elin66alpha/AI_figure/assets/renderer/e6ae1a68-8cda-431b-a01b-6ed6c8702f0f.png

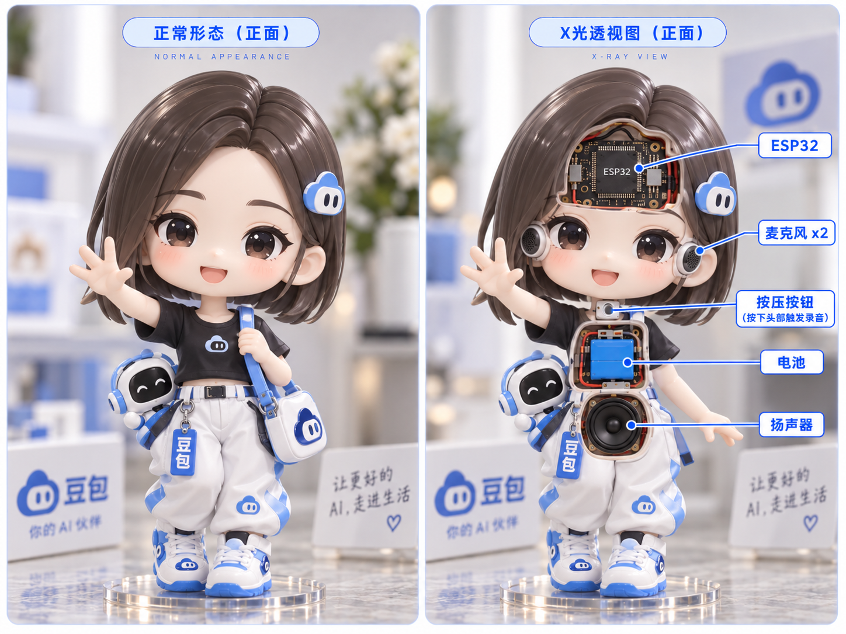
assets/renderer/e6ae1a68-8cda-431b-a01b-6ed6c8702f0f.png
