elin66alpha/AI_figure/assets/renderer/9f44d49e-f947-44cd-aeab-df2c80974dcf.png

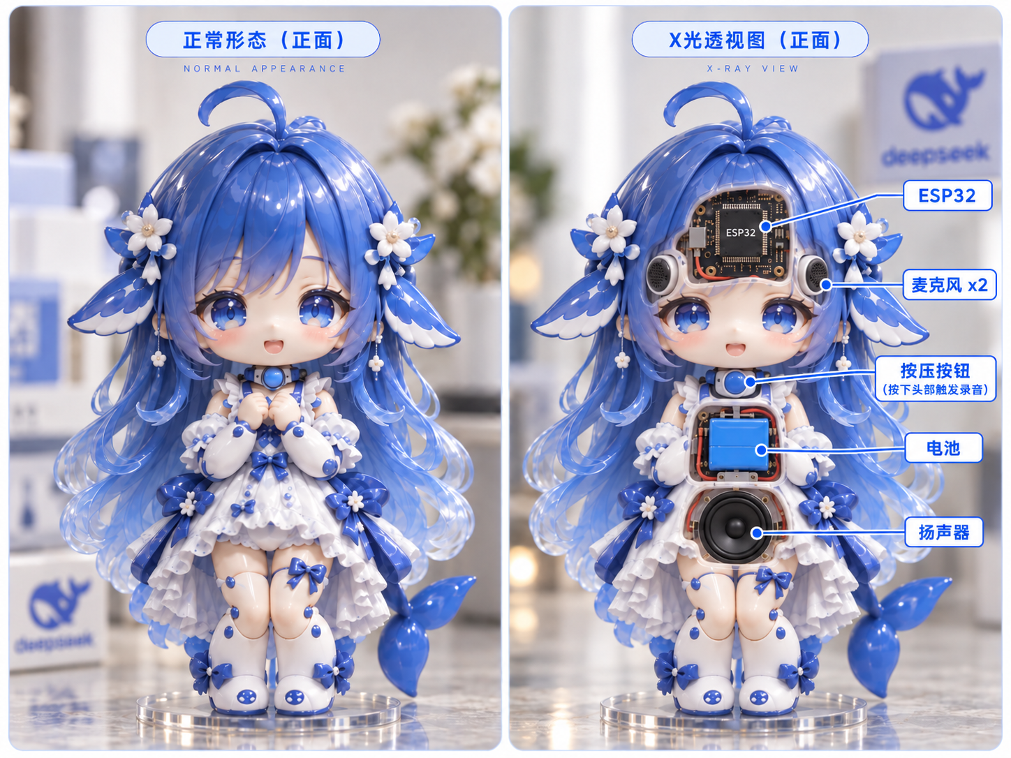
assets/renderer/9f44d49e-f947-44cd-aeab-df2c80974dcf.png
