elin66alpha/AI_figure/hardware/DESIGN_CONSTRAINTS.md

# AI_figure 定制板：最终设计约束

最终工程文件：`ProPrj_AI_figure_2026-10-08.epro2`（嘉立创 EDA 专业版）；BOM：`BOM/BOM_30x50_2026-10-07.csv`；器件手册：`datasheets/`。

## 板子与制造

- 30 × 50 mm 圆角矩形，双层 FR-4，板厚 1.6 mm，1 oz 铜，两面贴片。没有安装孔。
- 过孔 24/12 mil，两面盖油，不做填孔电镀。U2/U5 散热过孔在散热焊盘外侧，用短宽铜线接 EP，不做焊盘内过孔。
- USB D+/D- 两对差分对已等长（长度差约 0）。没有做阻抗控制，也没有向板厂指定阻抗。
- 走线规则：只有 0°/45°/90° 线段，每个拐弯 45°，不要 T 形分支。原生 DRC 通过（0 错误）。
- 位号丝印全部隐藏，板上不印位号；位号本身保留，BOM 和坐标文件靠它对应。

## 机械（外壳设计按此）

- **ESP32 模组 U1**：正面左上角，天线朝上贴顶边。天线下方 x 0–17.2、y 0–5.7 mm 所有铜层禁布。外壳在天线附近尽量不放金属。
- **麦克风 U4（LMD2718T261）**：正面右上 (24.5, 6.0) mm，顶部进声，PCB 不开声孔。四周 Ø10 mm 内不放元件，留给外壳密封垫。
- **电池**：500 mAh 聚合物锂电池，30×30×6 mm，自带保护板，贴在正面下部（y 19.5–50 mm，整板宽）。
- **USB-C J1**：立式（SHOU HAN TYPE-C 16PLT-H6.5，C3151748），在背面中部 (15, 34) mm。
- **J2 / J3 / J4**：电池、喇叭、录音键各一个 2.54 mm 2P 焊盘位，在正面电池上方，直接焊线，不装排针座。
- **喇叭**：Ø20×5 mm，不装在 PCB 上，焊线接 J3。

坐标原点为板子左上角，y 向下，单位 mm。

## 电路取舍

- 电池自带保护板，板上不做保护：已删 DW01A / 8205A，电池负极直接接 GND。
- 充电：ETA6002，R3 = 3.0 kΩ，充电电流约 0.33 A（约 0.67C @ 500 mAh）。NTC 脚接地，不检测电池温度。
- 3.3 V：U3 ETA5060 给主控，U7 TLV75733 单独给功放，两路都从 SYS 降压。电池电压低时 3.3 V 维持不住，固件需要设低电量关机阈值。
- 麦克风为 PDM：CLK = GPIO6，DATA = GPIO0，由软件抽取。功放 NS4168 走 I2S，AMP_CTRL 控制声道选择和关断。
- 电池电压检测：SYS_ADC（GPIO1）测的是 VBAT（电池正极，R14 上端接 VBAT），经 1 MΩ + 1 MΩ 分压、100 nF 滤波。网络名仍叫 SYS_ADC。只用电池时 SYS 比 VBAT 低“负载电流 × 50 mΩ”，低电量关机阈值留约 50 mV 余量；充电时读数偏高约 50–100 mV；不装电池只插 USB 时读数无意义。
- USB 插入检测：VBUS_DET（GPIO20，模组 RXD0 脚 30）= VBUS_CHG 经 R16 68 kΩ / R17 100 kΩ 分压，5 V 时约 3.0 V（4.4–5.5 V 对应 2.6–3.3 V，高于 0.75×VDD）。数字输入，不能从深睡唤醒（C3 深睡唤醒只支持 GPIO0–5）。ETA6002 的 STAT 脚未接。
- 没有 UART 排针，烧录和日志走 USB-Serial-JTAG。EN、BOOT 是测试焊盘 TP1（EN）、TP2（GND）、TP3（BOOT_GPIO9），不进 BOM。
