elin66alpha/AI_figure/ENGINEERING.md

# Engineering Contract

## Deviations

- [open] 2026-10-24: Engineering audit and full contract (Problem, Scope, Architecture, Features, Verification) skipped before adding the offline hardware self-test firmware (firmware/ESP32C3_HwTest) and its remote kit (hardware/bringup/自检包, run via 1-自检.bat). Reason: board bring-up is blocked on a remote engineer who has no network or server; the user asked to build the test firmware first.
