elin66alpha/AI_figure/ROADMAP.md

# ESP32-C3 AI Voice — 后续计划(路线图)

> 这里记录还没做完的计划,写下来是为了在改现有代码时别把路堵死。
> 设备侧规格见 `AGENT.md`,服务器侧见 `SERVER.md`。

---

## 1. 手机端:微信小程序(不做原生 App)

一个微信小程序(`miniprogram/`),按顺序做:① 蓝牙配网 → ② 用户注册/登录(微信登录或其他)→
③ 服务器数据库(用户、密码、订阅等级)+ 订阅付费。免费用户以后可能改用手机本地的 ASR/LLM/TTS,不走付费 API,待定。

| # | 功能 | 链路 | 依赖 |
|---|---|---|---|
| A1 | **蓝牙配网**:给 ESP32-C3 下发 WiFi SSID / 密码 | 小程序 ⇄ BLE ⇄ 设备 | **固件和 `miniprogram/` 已写,待真机验收**(AGENT.md §8) |
| A2 | **配置服务器连接**:服务器域名/端口、设备身份(PSK) | App ⇄ BLE ⇄ 设备 | 同上,且 PSK 要能在服务器侧登记 |
| A3 | **配置付费订阅服务**:选 ASR / TTS / 大模型的厂商与套餐 | App ⇄ HTTPS ⇄ 服务器 | 服务器按设备存配置 + 面向 App 的 API |
| A4 | **调喇叭音量** | App ⇄ 服务器 ⇄ WS ⇄ 设备(或 BLE 直连) | 固件运行期改增益 + 存 NVS |
| A5 | **查看整套系统电量** | 设备 ⇄ WS ⇄ 服务器 ⇄ App | 固件上报电池电压(见 §2) |

---

## 2. 电量 —— 硬件已有,App 侧还没做

定制板已经有电池电压采样(GPIO1,1 MΩ + 1 MΩ 分压)和 USB 插入检测(GPIO20)。
固件目前只用它做低电压保护,并在 `[TLM]` 遥测里打印 VBAT;没有换算成百分比,也没有上报给服务器。
要在小程序里看电量,还差:

- 设备通过 WS 上报电压(新增一条上行控制消息,服务器侧同步支持)
- 服务器转发给小程序
- 按电池放电曲线标定后再换算成百分比;采样放在 IDLE 时做,播放时的大电流压降会让读数偏低
- 插着 USB 充电时读数偏高,不装电池只插 USB 时读数没有意义(`hardware/DESIGN_CONSTRAINTS.md`)

---

## 3. 对现有代码的约束(**实施任何改动时都要记得**)

### 3.1 固件

- **音量要能在运行期改。** `audio_io` 的 `setOutputGain()` / `s_outGain` 是故意保留的运行期变量
  (其余标定旋钮都是编译期常量)。
  App 调音量时:收到新值 -> `setOutputGain()` -> 写 NVS,开机从 NVS 读,读不到用 `OUTPUT_GAIN_DEFAULT`。
  App 端的最大值要在实板上听着定,不能直接放到 256。
- **WiFi 凭据存 NVS**(命名空间 `net`),`secrets.h` 的 WiFi 两行只是开发用兜底。
  服务器地址 / PSK 仍编译期写死在 `secrets.h`,以后要下发时同样走 BLE 配网的加密会话(加自定义端点)。
- **分区是自定义双 OTA**(每槽 0x1E0000),保留了以后远程升级的能力。
- **堆:BLE 和 WiFi+TLS 最好不要同时常驻。** 建议"配网模式"单独进(比如长按按键 / NVS 里没有凭据),
  配完重启进正常模式,正常模式不初始化 BLE。
  **已按此实现**:`network_provisioning` Security 1,小程序端自己实现了协议客户端(`miniprogram/utils/prov.js`)。
- **PSK 就是设备身份**(AGENT.md §7)。配网时下发或生成 PSK 必须走加密通道
  (Security 1 会话里的自定义端点,`network_prov_mgr_endpoint_create`),不能明文走 BLE。
  注意当前**没有 PoP**:下发 PSK 之前要重新评估是否加 PoP。
- **新控制消息不会打坏老固件**:设备本来就静默忽略未知的 `t`(AGENT.md §3.2),
  音量 / 电量消息可以先在服务器上线。

### 3.2 服务器

- **厂商选择要从"全局环境变量"变成"按设备/用户配置"。** `asr.py` / `tts.py` / `llm.py`
  的分派层已经把厂商隔开了,到时候把 `config.*_PROVIDER` 换成按会话读配置即可。
  所以 **火山 `volc_*.py` 等备选厂商代码要保留**,它们会成为 App 里可选的选项。
- **厂商密钥**:用户自带 key 还是平台统一采购再按订阅收费,要先定。前者要加密存储;
  后者要做用量计量(ali_tts 里已经在累计计费字符数 `chars`)。
- **小程序支付**:接微信支付要求小程序主体是**企业或个体工商户**(个人主体不行),
  目前还没有 AppID,注册时就要选对主体。iOS 上小程序卖虚拟服务有平台限制,做到这一步时再查最新规则。
- **设备登记**:现在 PSK 手工写在 `/etc/stunnel/psk.secrets`。设备多了要自动化登记
  (stunnel 支持 `SIGHUP` 重载),或者升级到 Python 3.13 用 `set_psk_server_callback` 查库。
- **小程序需要一个面向手机的 API**(HTTPS + 用户鉴权,微信登录走 `wx.login` -> 服务器换 openid),
  和设备那条 WS 分开。小程序的 request 合法域名必须是备案过的 HTTPS 域名。
  音量下发、电量上报经服务器中转:小程序 -> API -> 找到设备的 WS 会话 -> 下发控制消息。
