elin66alpha/AI_figure/.easyeda/artifacts/20260929-184102-schematic_export-27a93d84.png

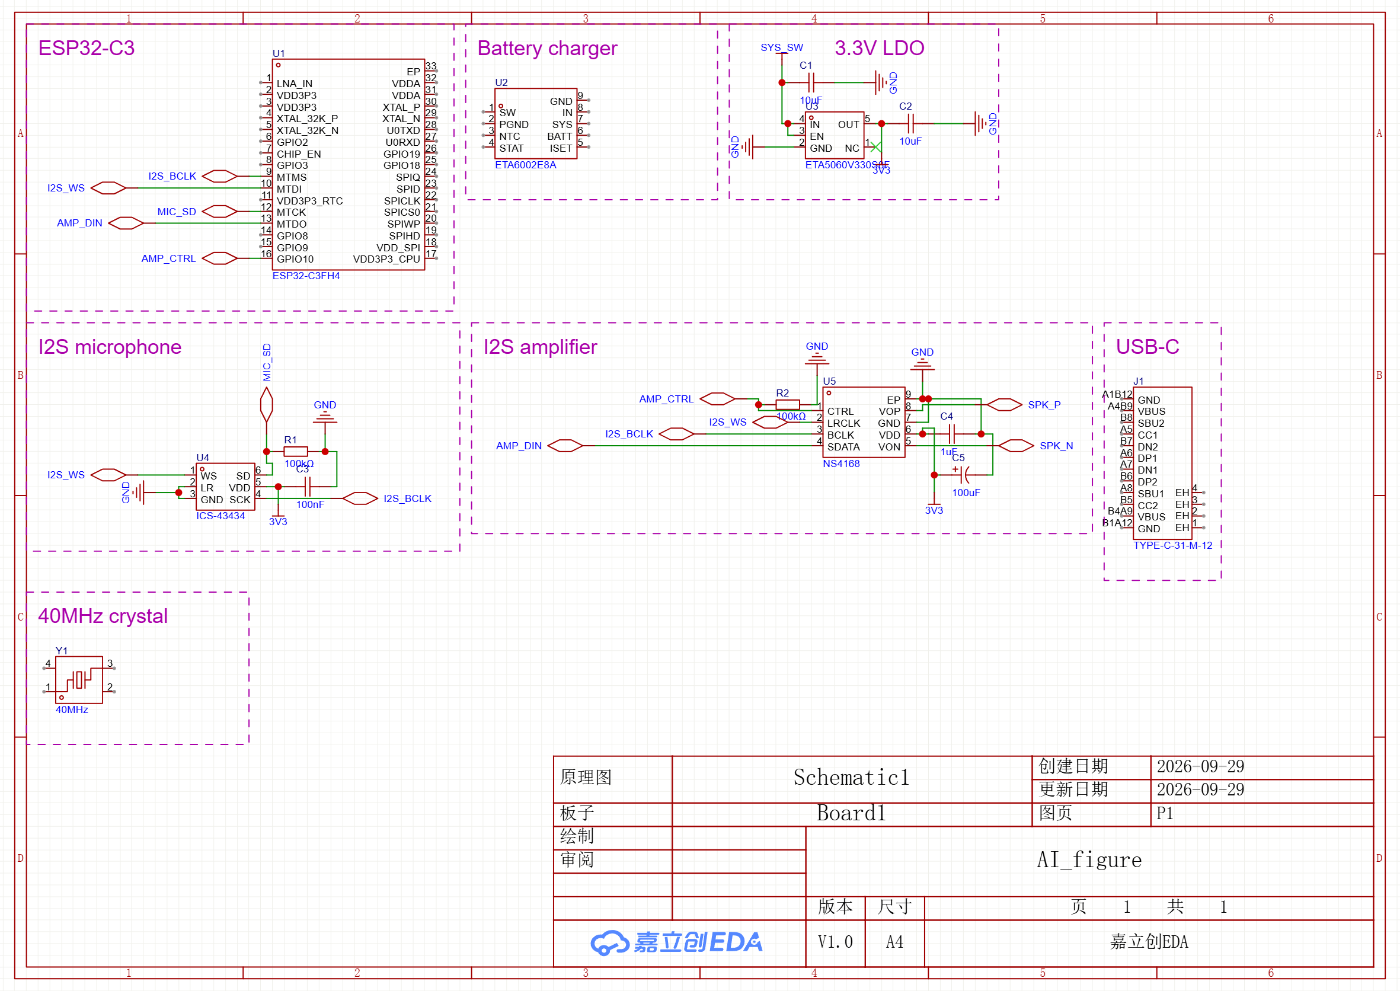
.easyeda/artifacts/20260929-184102-schematic_export-27a93d84.png
