elin66alpha/AI_figure/.easyeda/artifacts/20260929-192454-schematic_export-d0c1aed8.png

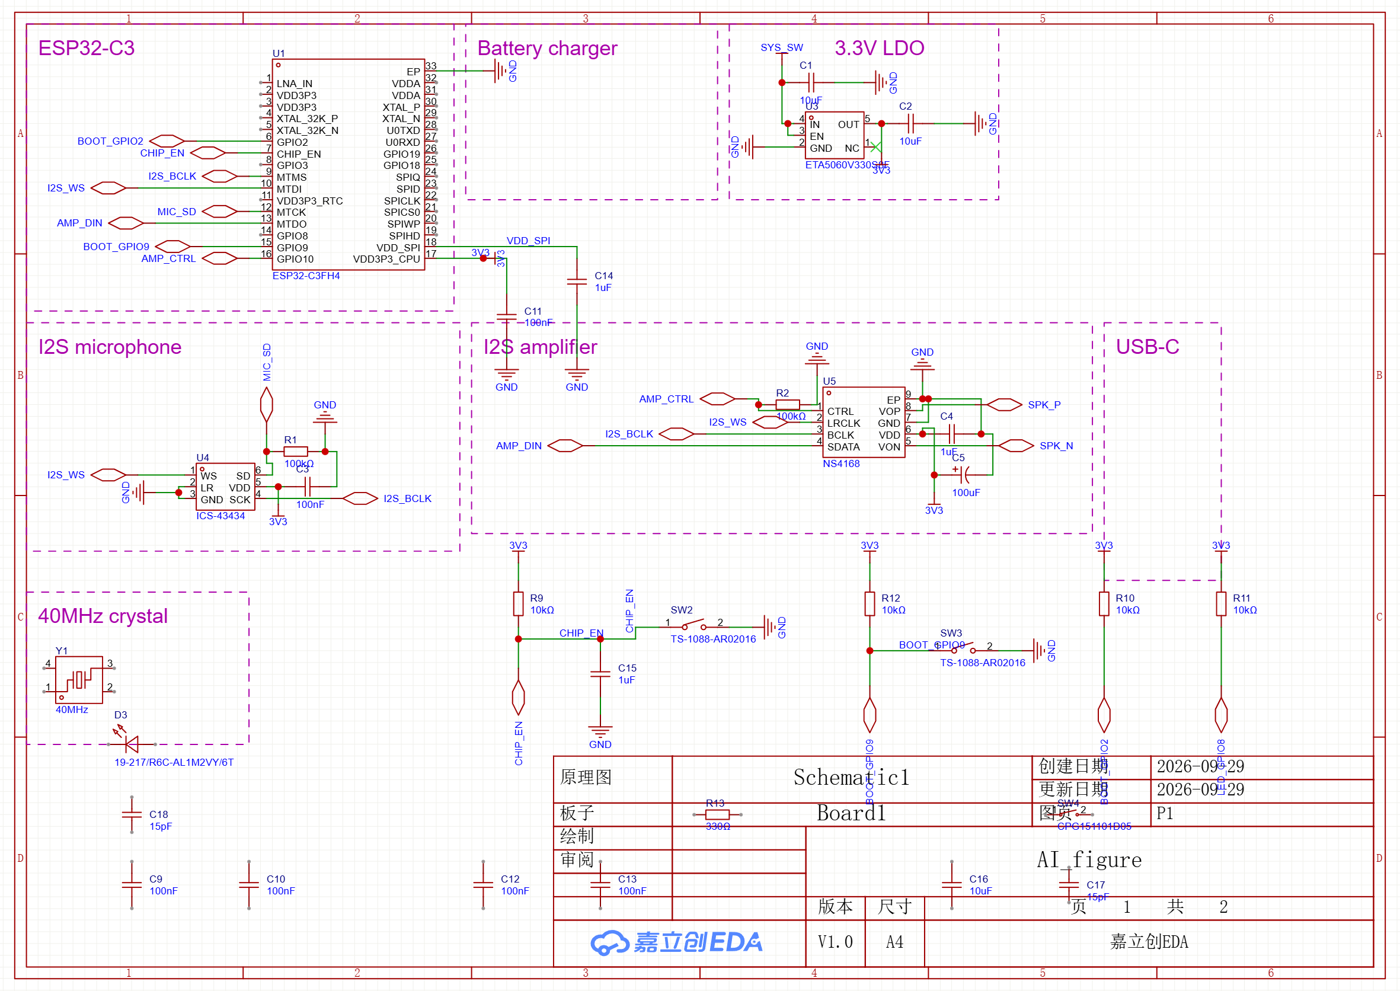
.easyeda/artifacts/20260929-192454-schematic_export-d0c1aed8.png
