elin66alpha/AI_figure/.easyeda/artifacts/20260929-194359-schematic_export-5978b97b.png

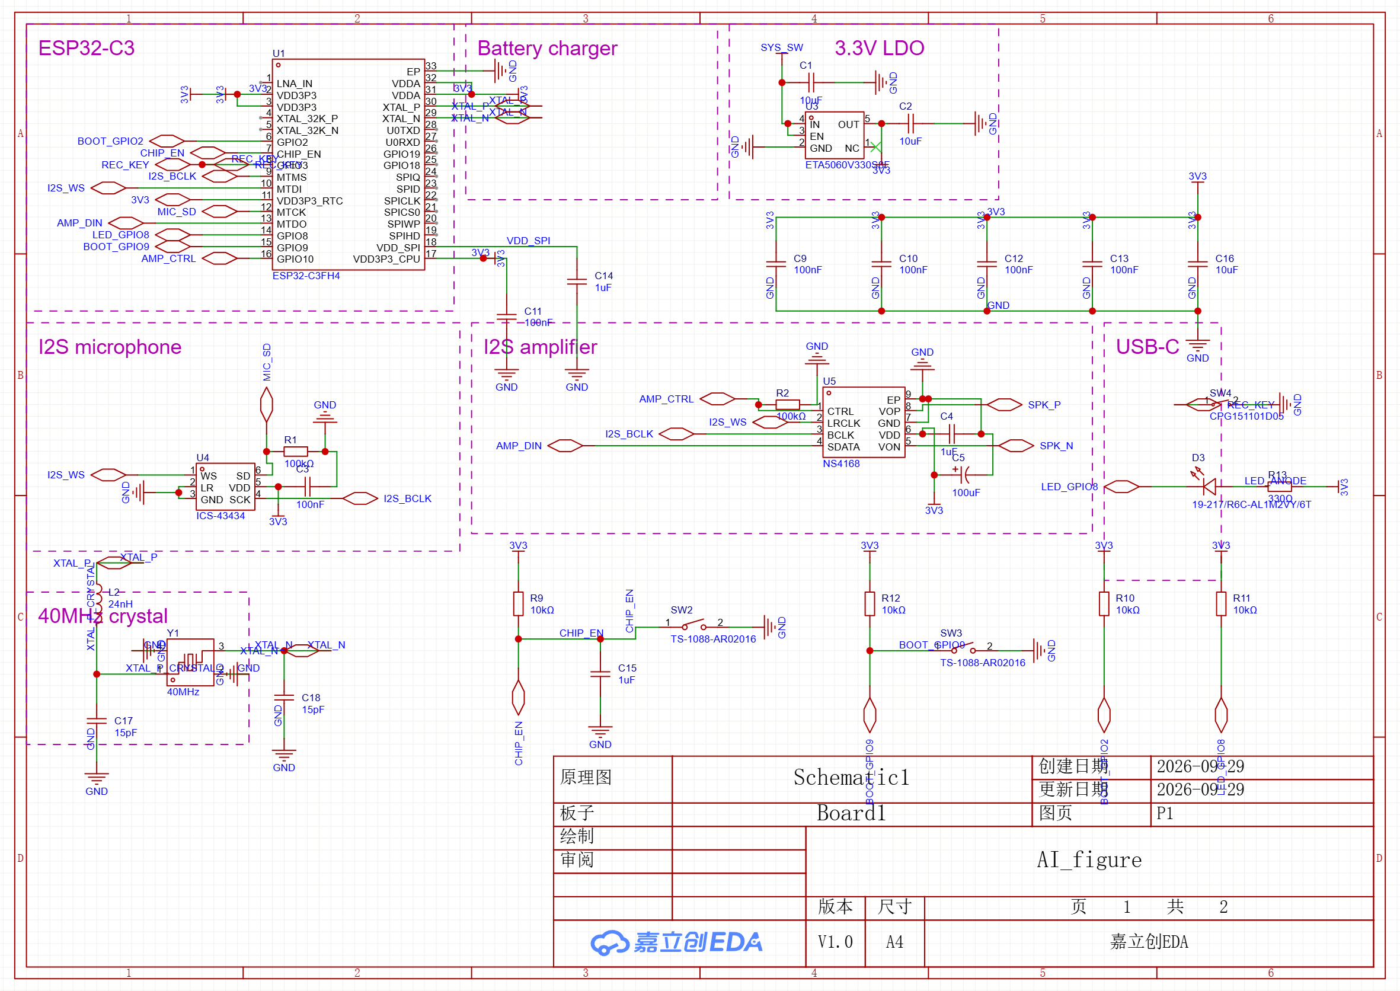
.easyeda/artifacts/20260929-194359-schematic_export-5978b97b.png
