elin66alpha/AI_figure/.easyeda/artifacts/20260929-200443-schematic_export-7b6031b6.png

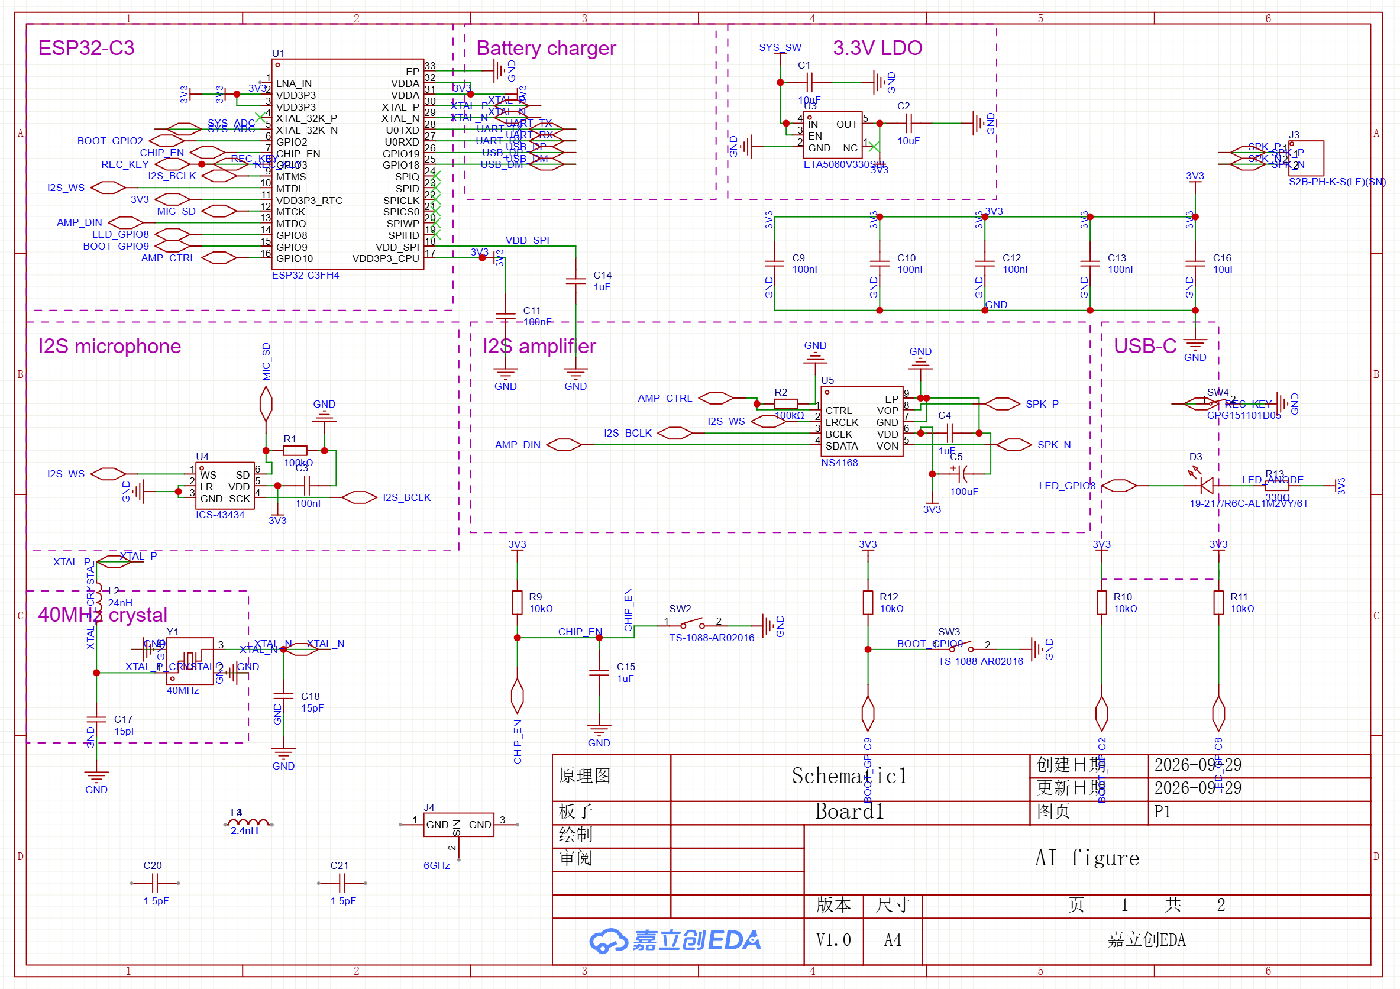
.easyeda/artifacts/20260929-200443-schematic_export-7b6031b6.png
