elin66alpha/AI_figure/.easyeda/artifacts/20260929-200511-schematic_export-a2d3e605.png

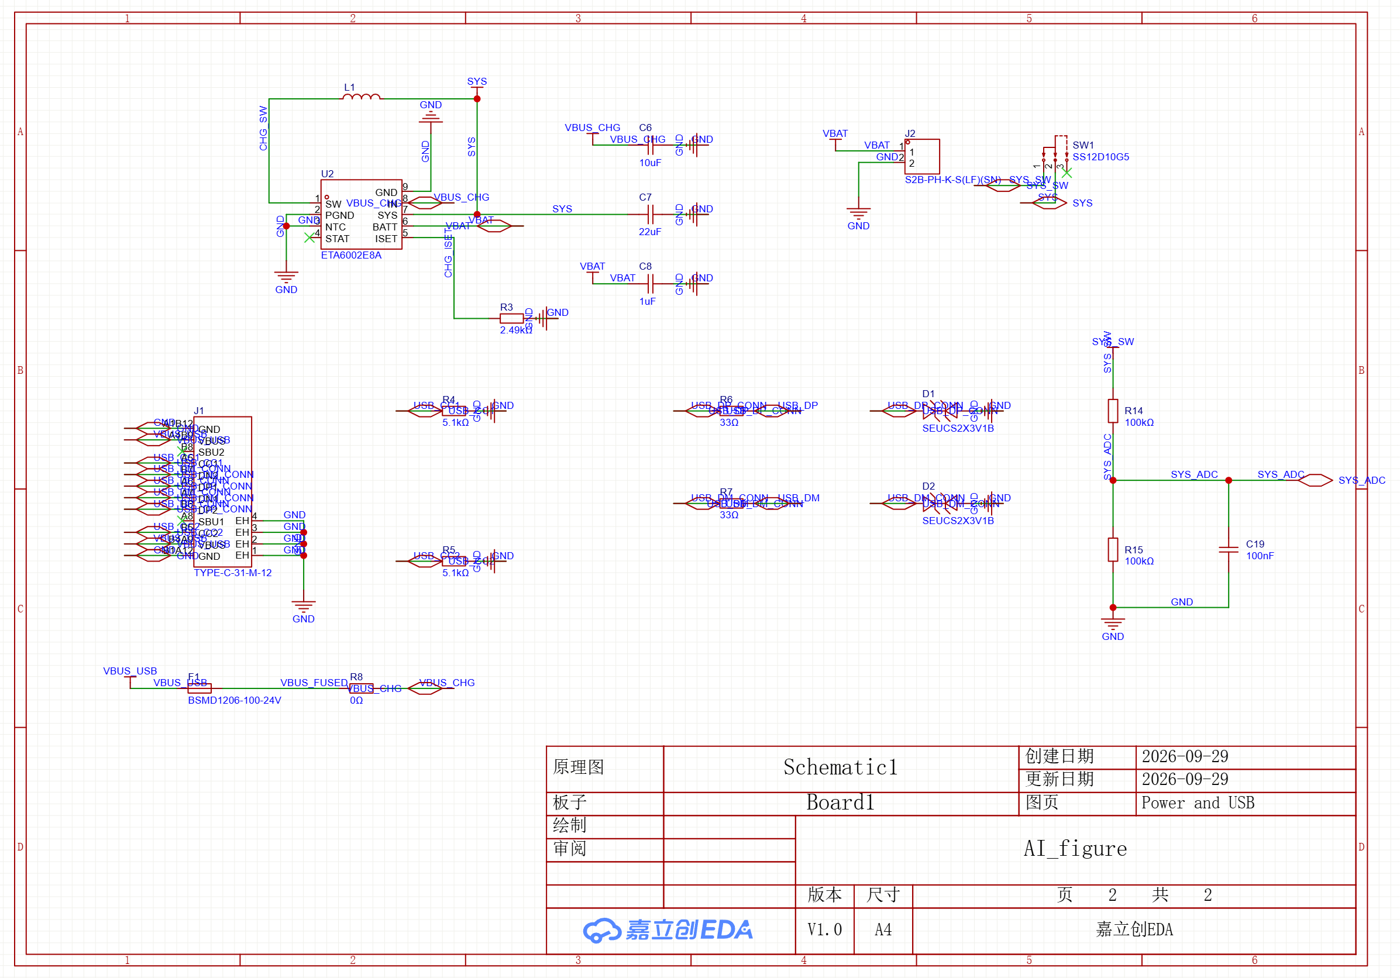
.easyeda/artifacts/20260929-200511-schematic_export-a2d3e605.png
