elin66alpha/AI_figure/.easyeda/artifacts/20260929-202914-schematic_export-4d398066.png

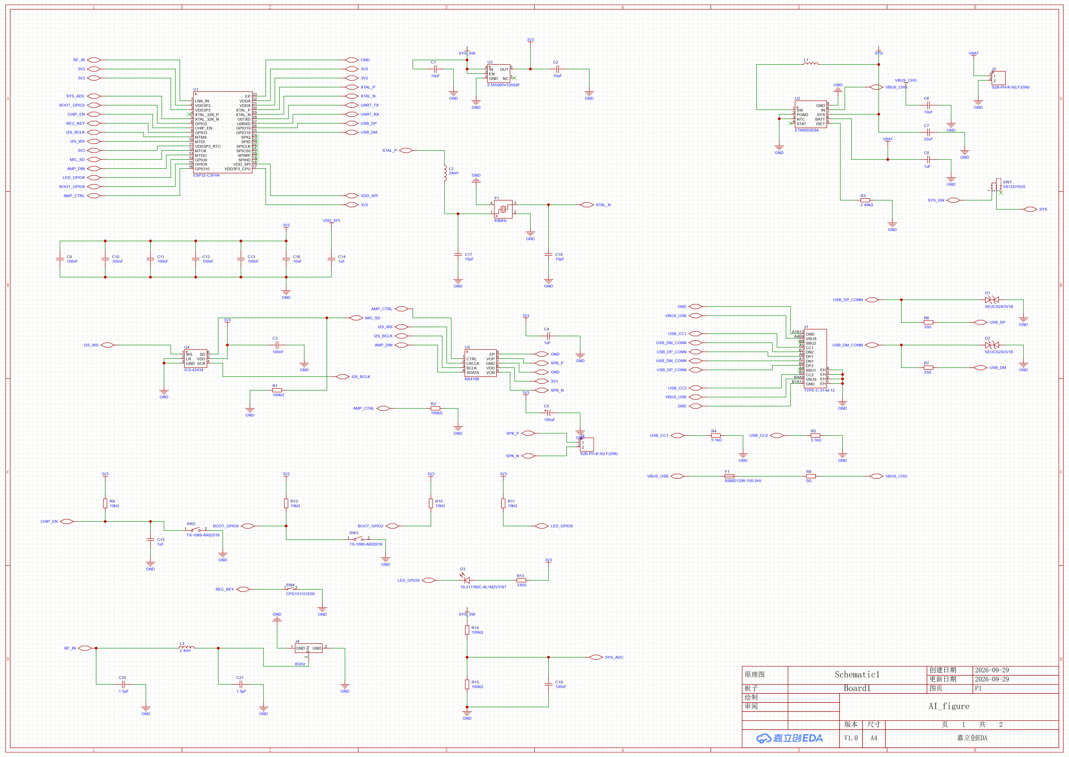
.easyeda/artifacts/20260929-202914-schematic_export-4d398066.png
