elin66alpha/AI_figure/.easyeda/artifacts/20260929-204429-schematic_export-d9c69031.png

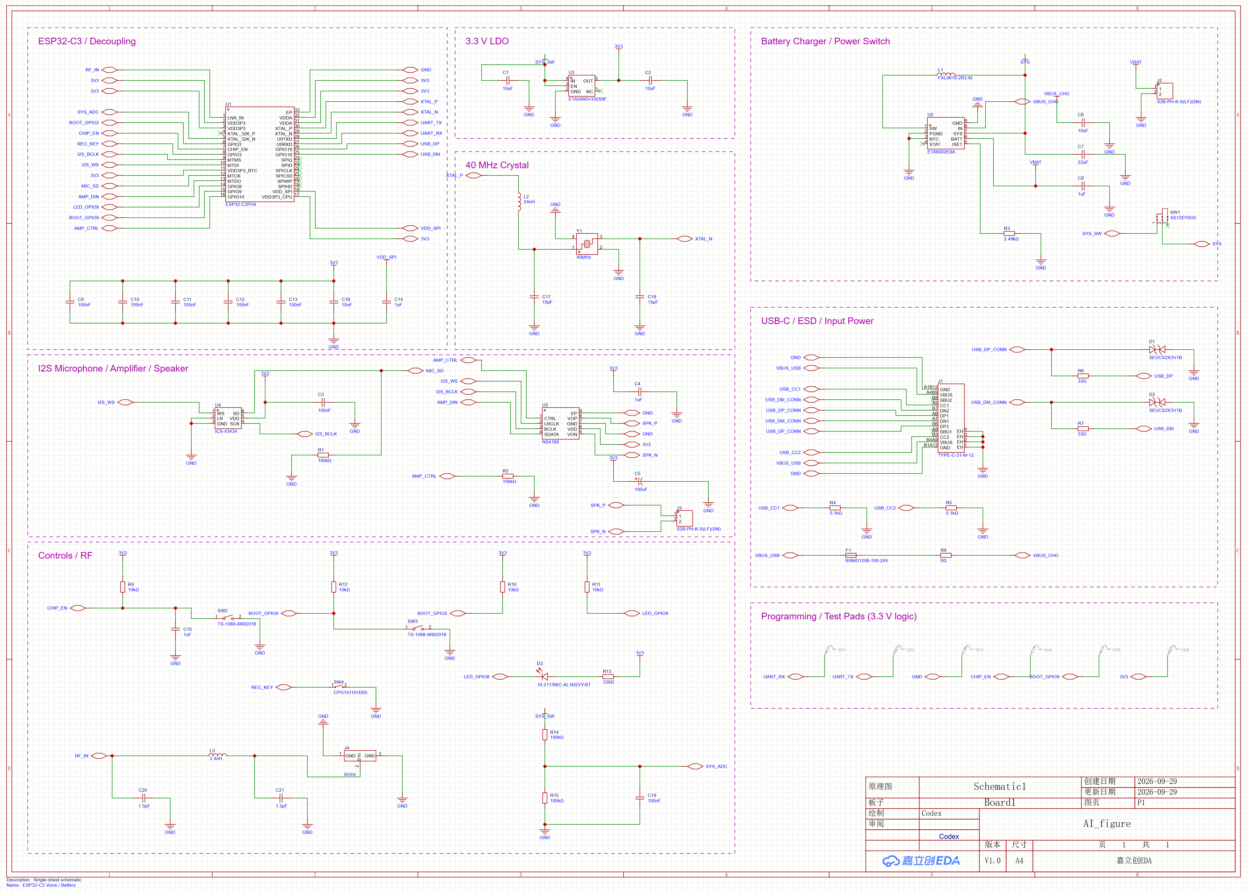
.easyeda/artifacts/20260929-204429-schematic_export-d9c69031.png
