elin66alpha/AI_figure/.easyeda/artifacts/20260929-204615-schematic_export-d0ac80e4.png

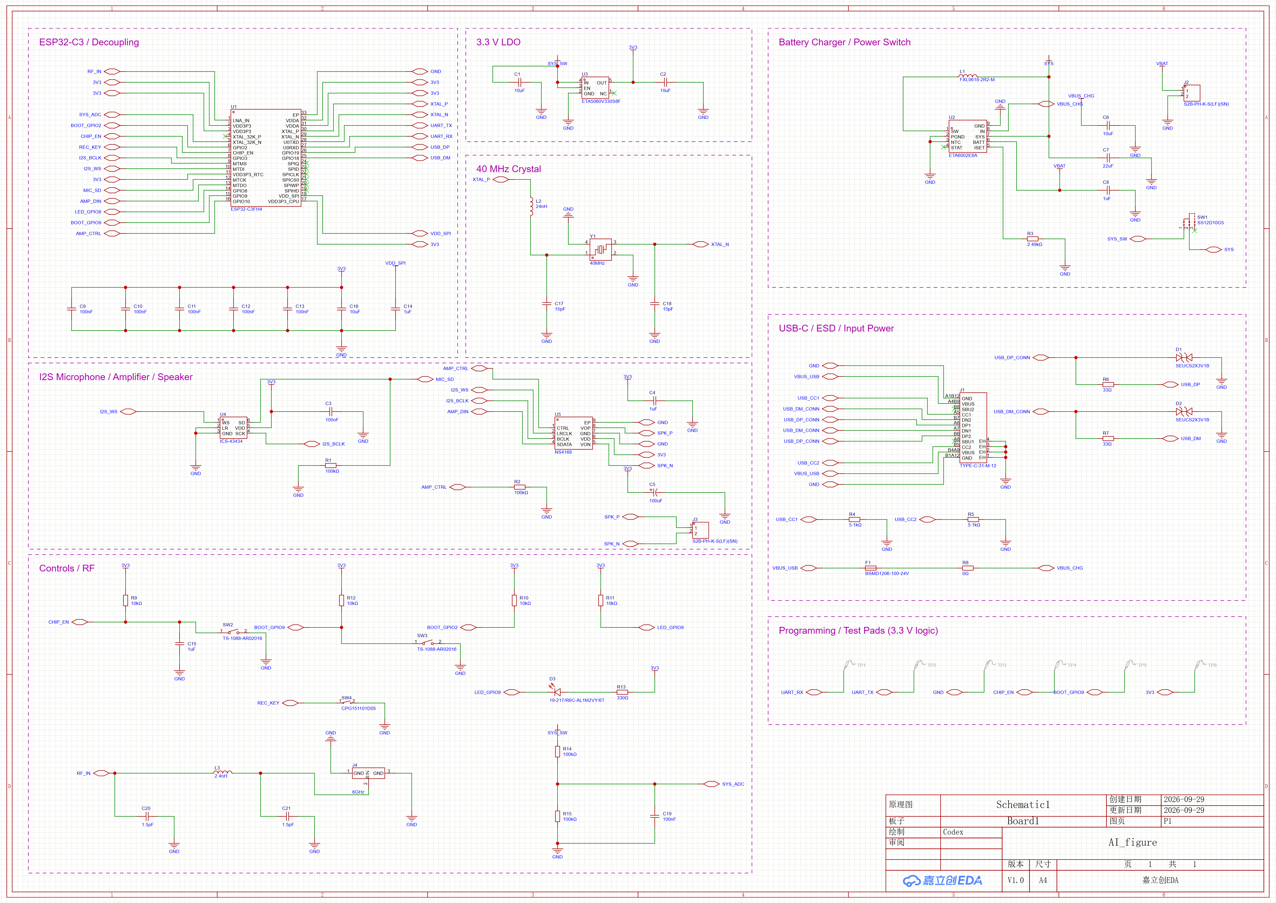
.easyeda/artifacts/20260929-204615-schematic_export-d0ac80e4.png
