elin66alpha/AI_figure/.easyeda/artifacts/20261006-173509-schematic_export-06e082d4.png

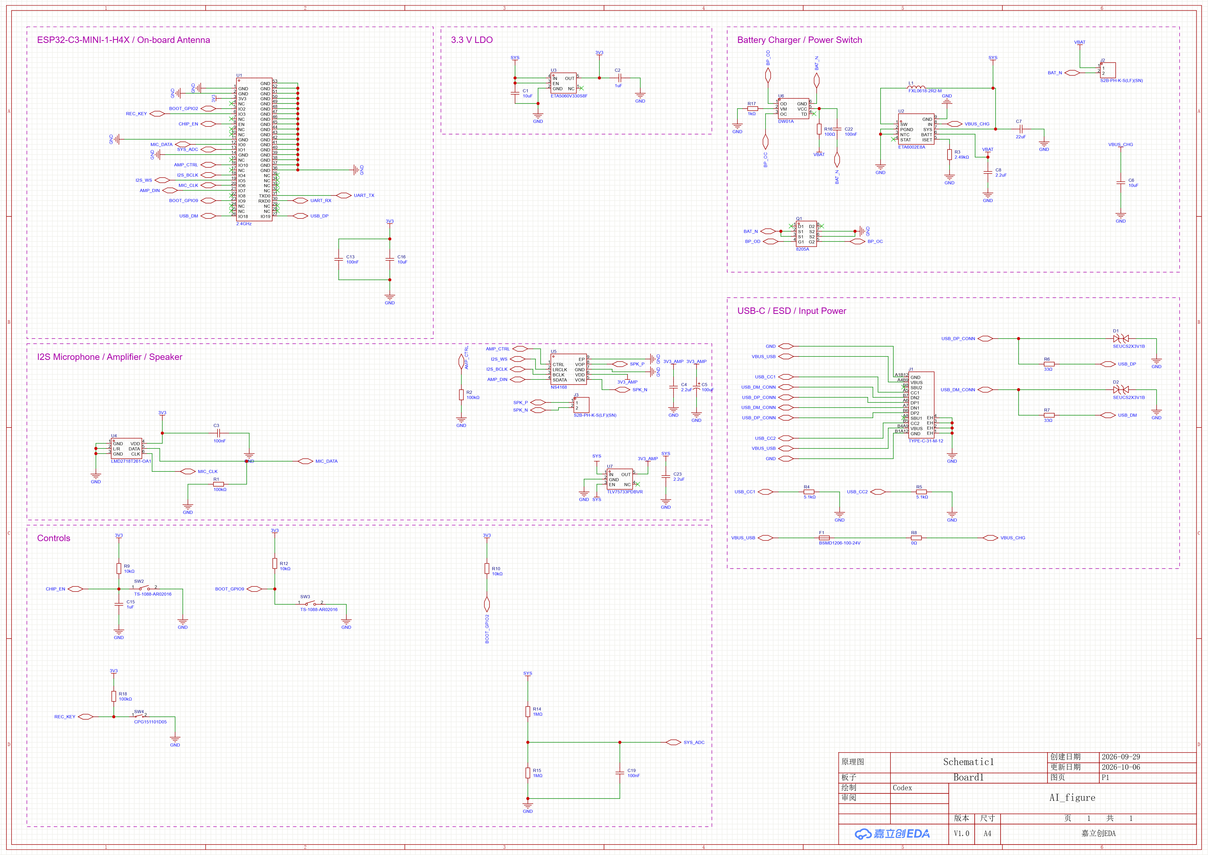
.easyeda/artifacts/20261006-173509-schematic_export-06e082d4.png
