elin66alpha/AI_figure/.easyeda/artifacts/20261006-193431-schematic_export-45f057d5.png

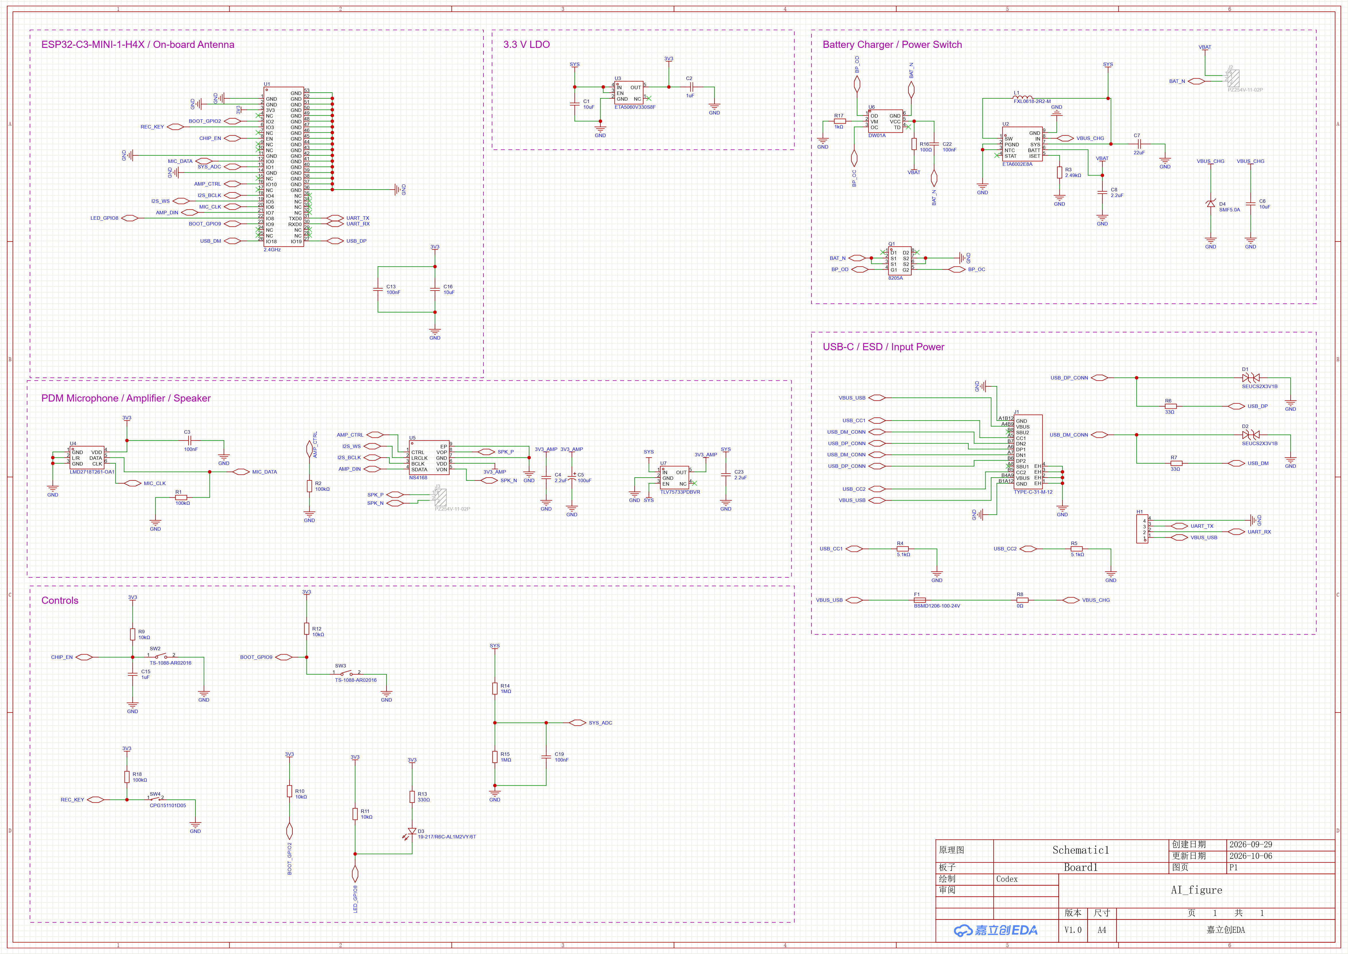
.easyeda/artifacts/20261006-193431-schematic_export-45f057d5.png
