elin66alpha/AI_figure/.easyeda/artifacts/20261006-224235-pcb_snapshot-fa77d5bd.png

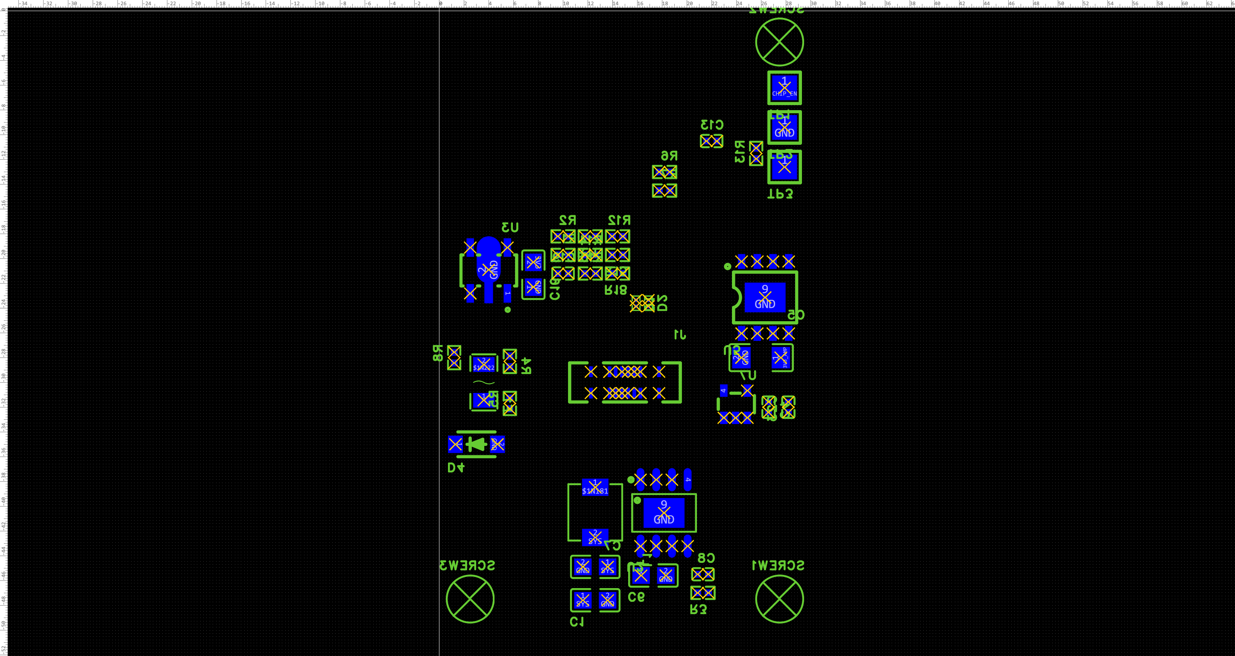
.easyeda/artifacts/20261006-224235-pcb_snapshot-fa77d5bd.png
