elin66alpha/AI_figure/.easyeda/artifacts/20261007-025754-pcb_snapshot-379939ef.png

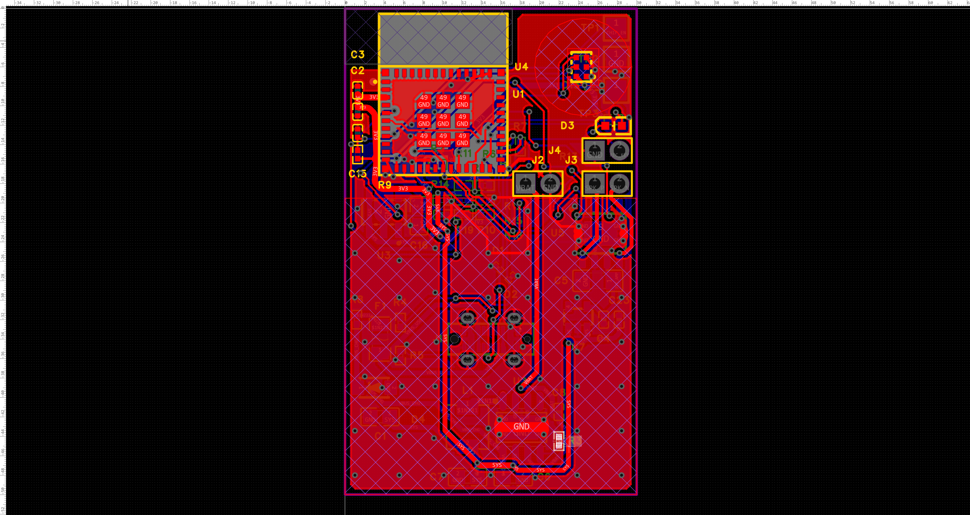
.easyeda/artifacts/20261007-025754-pcb_snapshot-379939ef.png
