elin66alpha/AI_figure/.easyeda/artifacts/20261016-233853-pcb_snapshot-adba5ace.png

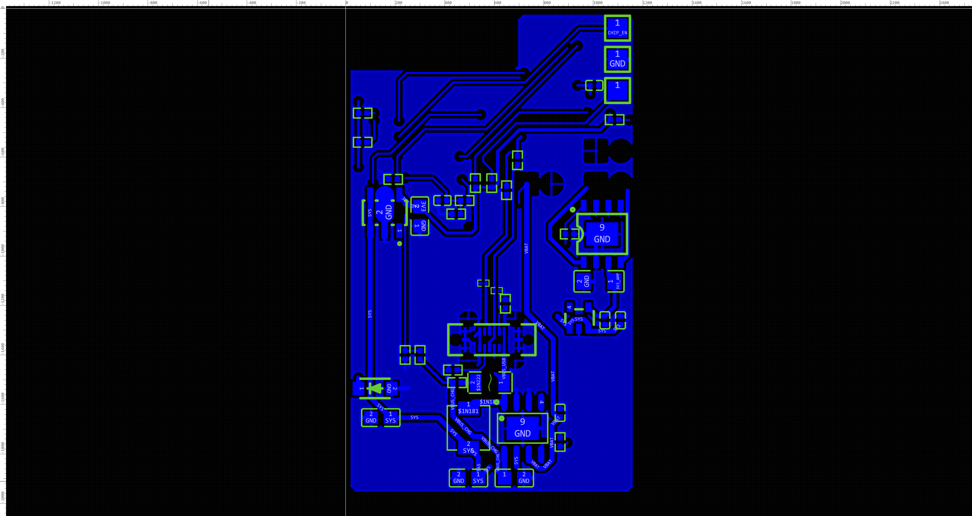
.easyeda/artifacts/20261016-233853-pcb_snapshot-adba5ace.png
