elin66alpha/AI_figure/assets/renderer/649875e9-ef43-426a-9d49-24b67acfeca1.png

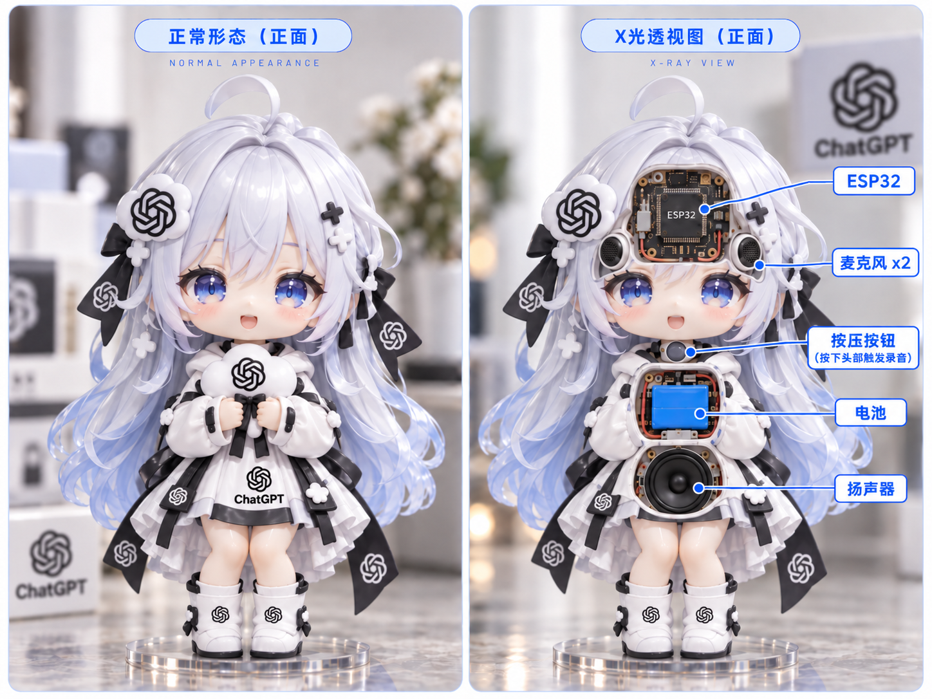
assets/renderer/649875e9-ef43-426a-9d49-24b67acfeca1.png
