elin66alpha/AI_figure/mechanic/export/1a2a62c7fec95a44b6e669c84b1b3a7a.jpg

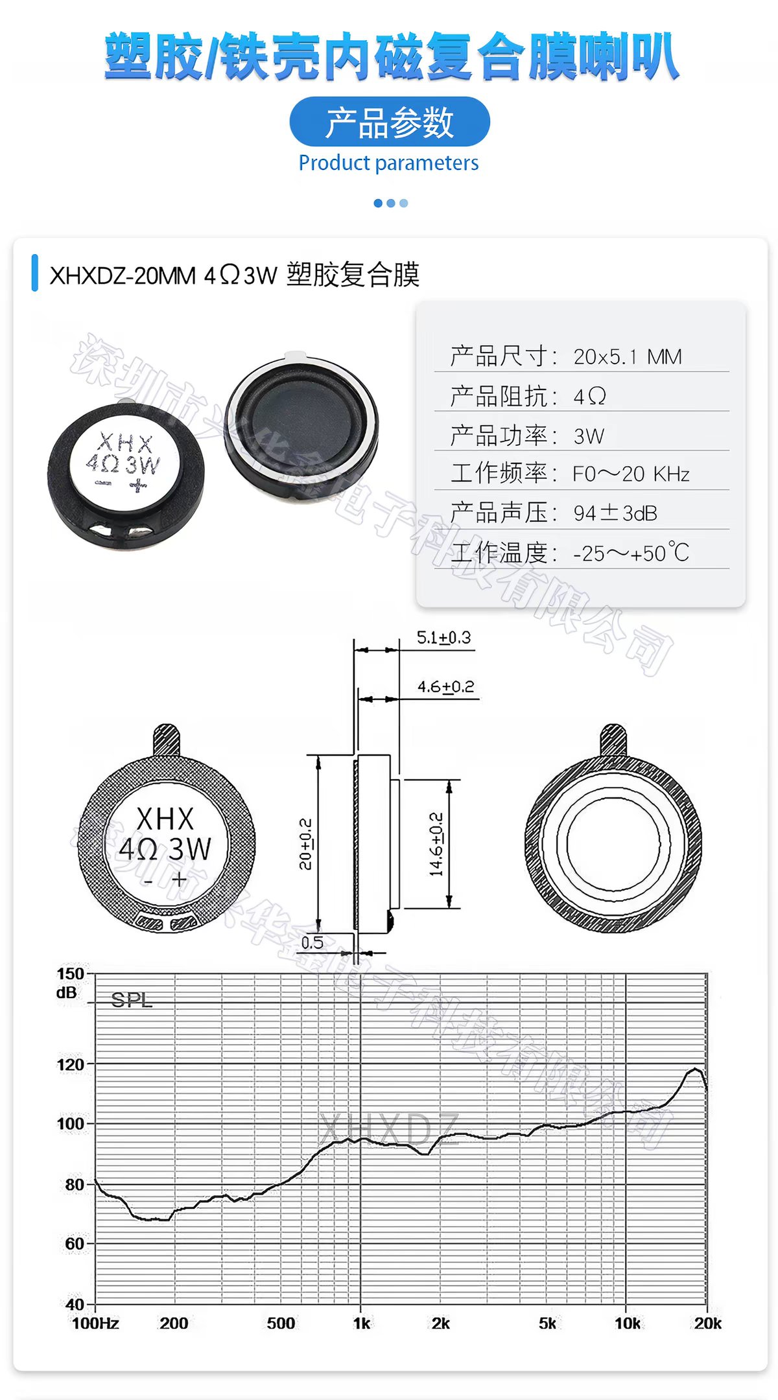
mechanic/export/1a2a62c7fec95a44b6e669c84b1b3a7a.jpg
