elin66alpha/AI_figure/renderer/b0d1a567-6355-4e40-a5f2-5a8ac267f8f7.png

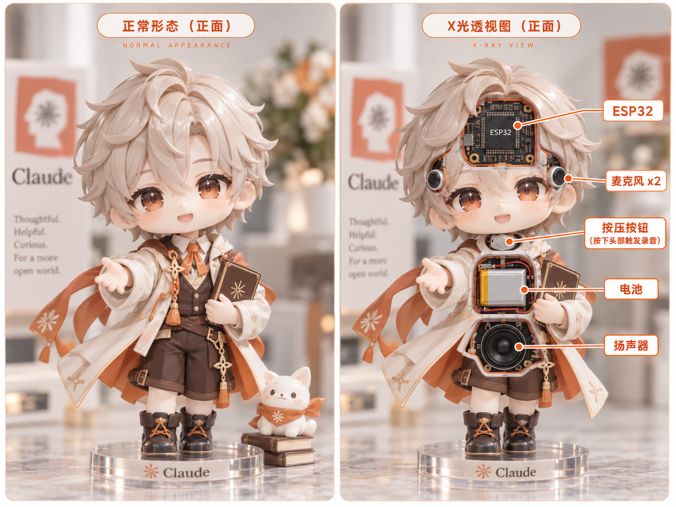
renderer/b0d1a567-6355-4e40-a5f2-5a8ac267f8f7.png
