elin66alpha/AI_figure/hardware/assembly/purchase.csv

row | first_designator | qty_per_board | mpn | brand | package | lcsc | qty_bought
1 | C1 | 3 | HGC0805R5106K250NSLJ | Chinocera(华瓷) | 0805 | C19103847 | 30
2 | C2 | 2 | GRM155R61E105KA12D | muRata(村田) | 0402 | C77009 | 100
3 | C3 | 3 | CL05B104KO5NNNC | SAMSUNG(三星) | 0402 | C1525 | 100
4 | C4 | 3 | CL05A225KA5NUNC | SAMSUNG(三星) | 0402 | C307418 | 40
5 | C5 | 1 | CL31A107MQHNNNE | SAMSUNG(三星) | 1206 | C15008 | 10
6 | C7 | 1 | 0805X226M100NT | FH(风华) | 0805 | C503482 | 10
7 | D1 | 2 | SEUCS2X3V1B | ElecSuper(静芯) | DFN0603-2 | C42400191 | 20
8 | D3 | 1 | 19-217/R6C-AL1M2VY/6T | EVERLIGHT(亿光) | 0603 | C2986060 | 50
9 | D4 | 1 | SMF5.0A | JSMSEMI(杰盛微) | SOD-123FL | C2857263 | 50
10 | F1 | 1 | BSMD1206-100-24V | BHFUSE(佰宏) | 1206 | C910830 | 10
11 | J1 | 1 | TYPE-C 16PLT-H6.5 | SHOU HAN(首韩) | SMD | C3151748 | 10
12 | L1 | 1 | FXL0420-2R2-M | cjiang(长江微电) | SMD 4.4x4.2 | C167206 | 10
13 | R1 | 4 | 0402WGF1003TCE | UNI-ROYAL(厚声) | 0402 | C25741 | 100
14 | R3 | 1 | FRC0402F3001TS | FOJAN(富捷) | 0402 | C2909355 | 100
15 | R4 | 2 | 0402WGF5101TCE | UNI-ROYAL(厚声) | 0402 | C25905 | 100
16 | R6 | 2 | RC0402FR-0733RL | YAGEO(国巨) | 0402 | C138002 | 100
17 | R8 | 1 | FRC0402F0000TS | FOJAN(富捷) | 0402 | C2906858 | 100
18 | R9 | 4 | FRC0402F1002TS | FOJAN(富捷) | 0402 | C2906861 | 100
19 | R13 | 1 | 0402WGF3300TCE | UNI-ROYAL(厚声) | 0402 | C25104 | 100
20 | R14 | 2 | 0402WGF1004TCE | UNI-ROYAL(厚声) | 0402 | C26083 | 100
21 | R16 | 1 | 0402WGF6802TCE | UNI-ROYAL(厚声) | 0402 | C36871 | 100
22 | U1 | 1 | ESP32-C3-MINI-1-H4X | ESPRESSIF(乐鑫) | SMD 16.6x13.2 | C41349510 | 10
23 | U2 | 1 | ETA6002E8A | ETA(钰泰) | ESOP-8 | C7436031 | 10
24 | U3 | 1 | ETA5060V330S8F | ETA(钰泰) | SOT89-5 | C7465551 | 10
25 | U4 | 1 | LMD2718T261-OA1 | LinkMems(聆麦声学) | SMD-6P 2.8x1.9 | C5373237 | 10
26 | U5 | 1 | NS4168 | Nsiway(纳芯威) | ESOP-8-EP | C910588 | 10
27 | U7 | 1 | TLV75733PDBVR | TI(德州仪器) | SOT-23-5 | C485517 | 10
