elin66alpha/AI_figure/.easyeda/artifacts/20261005-003304-schematic_bom-d3196b7b.csv

No. | Quantity | Comment | Designator | Footprint | Value | Manufacturer Part | Manufacturer | Supplier Part | Supplier
1 | 3 | 10uF | C1,C6,C16 | C0805 | 10uF | HGC0805R5106K250NSLJ | Chinocera(华瓷) | C19103847 | LCSC
2 | 2 | 1uF | C2,C15 | C0402 | 1uF | CL05A105KA5NQNC | SAMSUNG(三星) | C52923 | LCSC
3 | 4 | 100nF | C3,C13,C19,C22 | C0402 | 100nF | CL05B104KO5NNNC | SAMSUNG(三星) | C1525 | LCSC
4 | 3 | 2.2uF | C4,C8,C23 | C0402 | 2.2uF | CL05A225KA5NUNC | SAMSUNG(三星) | C307418 | LCSC
5 | 1 | 100uF | C5 | CAP-SMD_BD5.0-L5.3-W5.3-LS6.0-FD-H5.4 | 100uF | RVT6.3V100M5X5 | JIERR(捷而瑞) | C49233126 | LCSC
6 | 1 | 22uF | C7 | C0805 | 22uF | 0805X226M100NT | FH(风华) | C503482 | LCSC
7 | 2 | SEUCS2X3V1B | D1,D2 | DFN0603-2L-BI |  | SEUCS2X3V1B | ElecSuper(静芯) | C42400191 | LCSC
8 | 1 | 19-217/R6C-AL1M2VY/6T | D3 | LED0603-R-FD |  | 19-217/R6C-AL1M2VY/6T | EVERLIGHT(亿光) | C2986060 | LCSC
9 | 1 | BSMD1206-100-24V | F1 | F1206 |  | BSMD1206-100-24V | BHFUSE(佰宏) | C910830 | LCSC
10 | 1 | TYPE-C-31-M-12 | J1 | USB-C_SMD-TYPE-C-31-M-12_1 |  | TYPE-C-31-M-12 | 韩国韩荣 | C165948 | LCSC
11 | 2 | S2B-PH-K-S(LF)(SN) | J2,J3 | CONN-TH_S2B-PH-K-S-LF-SN |  | S2B-PH-K-S(LF)(SN) | JST | C173752 | LCSC
12 | 1 | FXL0618-2R2-M | L1 | IND-SMD_L7.0-W6.6_FXL0630 |  | FXL0618-2R2-M | cjiang(长江微电) | C524593 | LCSC
13 | 1 | 8205A | Q1 | TSSOP-8_L4.4-W3.0-P0.65-LS6.4-TL | 8205A | 8205A | TECH PUBLIC(台舟) | C7419210 | LCSC
14 | 3 | 100kΩ | R1,R2,R18 | R0402 | 100kΩ | 0402WGF1003TCE | UNI-ROYAL(厚声) | C25741 | LCSC
15 | 1 | 2.49kΩ | R3 | R0402 | 2.49kΩ | 0402WGF2491TCE | UNI-ROYAL(厚声) | C25884 | LCSC
16 | 2 | 5.1kΩ | R4,R5 | R0402 | 5.1kΩ | 0402WGF5101TCE | UNI-ROYAL(厚声) | C25905 | LCSC
17 | 2 | 33Ω | R6,R7 | R0402 | 33Ω | RC0402FR-0733RL | YAGEO(国巨) | C138002 | LCSC
18 | 1 | 0Ω | R8 | R0402 | 0Ω | 0402WGF0000TCE | UNI-ROYAL(厚声) | C17168 | LCSC
19 | 4 | 10kΩ | R9,R10,R11,R12 | R0402 | 10kΩ | 0402WGF1002TCE | UNI-ROYAL(厚声) | C25744 | LCSC
20 | 1 | 330Ω | R13 | R0402 | 330Ω | 0402WGF3300TCE | UNI-ROYAL(厚声) | C25104 | LCSC
21 | 2 | 1MΩ | R14,R15 | R0402 | 1MΩ | 0402WGF1004TCE | UNI-ROYAL(厚声) | C26083 | LCSC
22 | 1 | 100Ω | R16 | R0402 | 100Ω | RC0402FR-07100RL | YAGEO(国巨) | C106232 | LCSC
23 | 1 | 1kΩ | R17 | R0402 | 1kΩ | RC0402FR-071KL | YAGEO(国巨) | C106235 | LCSC
24 | 2 | TS-1088-AR02016 | SW2,SW3 | SW-SMD_L3.9-W3.0-P4.45 |  | TS-1088-AR02016 | XUNPU(讯普) | C720477 | LCSC
25 | 1 | CPG151101D05 | SW4 | SW-TH_CPG151101D05 |  | CPG151101D05 | HanElectricity(瀚源) | C49234236 | LCSC
26 | 1 | 2.4GHz | U1 | WIFIM-SMD_ESP32-C3-MINI-1 | 2.4GHz | ESP32-C3-MINI-1-H4X | ESPRESSIF(乐鑫) | C41349510 | LCSC
27 | 1 | ETA6002E8A | U2 | ESOP-8_L4.9-W3.9-P1.27-LS6.0-BL-EP-1 |  | ETA6002E8A | ETA(钰泰) | C7436031 | LCSC
28 | 1 | ETA5060V330S8F | U3 | SOT-89-5_L4.5-W2.5-P1.50-LS4.6-BL |  | ETA5060V330S8F | ETA(钰泰) | C7465551 | LCSC
29 | 1 | ICS-43434 | U4 | MIC-SMD_6P-L3.5-W2.7-P0.90-BL |  | ICS-43434 | TDK InvenSense(应美盛) | C5656610 | LCSC
30 | 1 | NS4168 | U5 | ESOP-8_L4.9-W3.9-P1.27-LS6.0-BL-EP |  | NS4168 | Nsiway(纳芯威) | C910588 | LCSC
31 | 1 | DW01A | U6 | SOT-23-6_L2.9-W1.6-P0.95-LS2.8-BL |  | DW01A | PUOLOP(迪浦) | C351410 | LCSC
32 | 1 | TLV75733PDBVR | U7 | SOT-23-5_L2.9-W1.6-P0.95-LS2.8-BL |  | TLV75733PDBVR | TI(德州仪器) | C485517 | LCSC
