elin66alpha/AI_figure/hardware/BOM/c3bfd9e86d0bf8306d8e2dab7f3f90c9.png

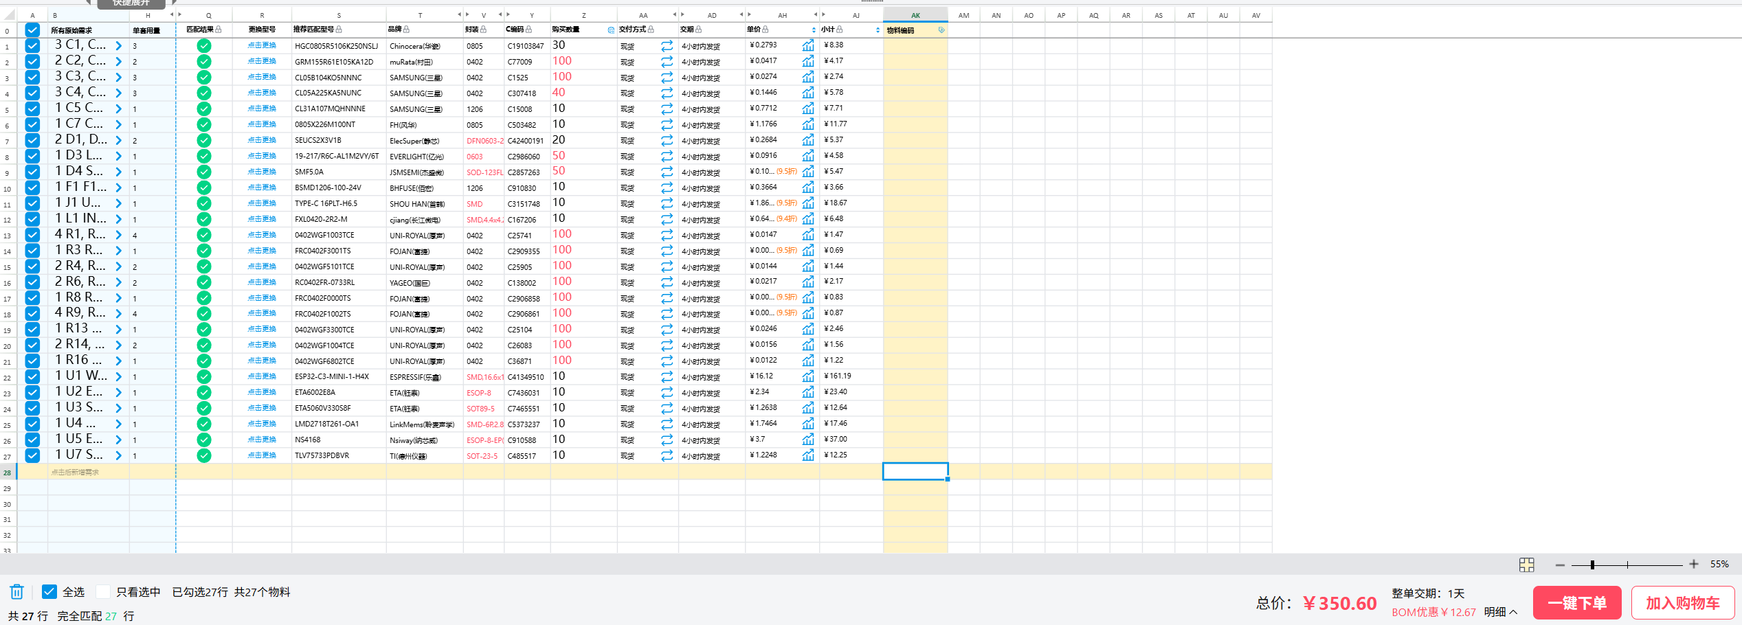
hardware/BOM/c3bfd9e86d0bf8306d8e2dab7f3f90c9.png
