elin66alpha/AI_figure/mechanic/3D_PCB1_2026-10-17.step

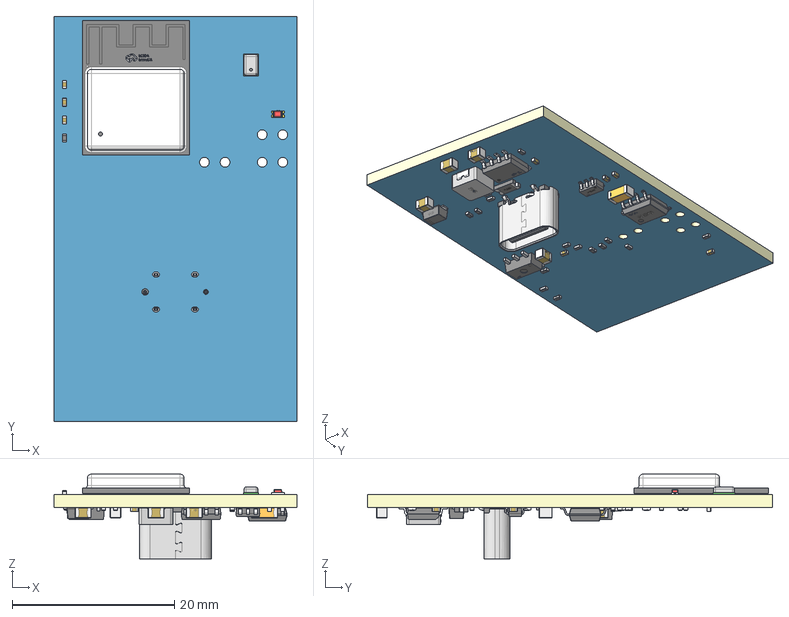
[picture p20: CAD file, 2026-10-17]
mechanic/3D_PCB1_2026-10-17.step
30.0 x 50.0 x 10.5 mm
Board~6WFS
TopCopper~6WFS
BottomCopper~6WFS
TopSilkscreen~6WFS
BottomSilkscreen~6WFS
TopFpcStiffener~6WFS
BottomFpcStiffener~6WFS
C0805~C0805_L2.0-W1.3-H1.3~3wkt x 4
LED0603-R-FD~LED0603-R-FD~t7OX
C0402~C0402_L1.0-W0.5-H0.5~WAJ9 x 8
SOD-123FL_L2.8-W1.9-LS3.7-RD~SOD-123FL_L2.8-W1.9-LS3.7-RD~KsN1
ESOP-8_L4.9-W3.9-P1.27-LS6.0-BL-EP-1~ESOP-8_L4.9-W3.9-P1.27-LS6.0-BL-EP-1~gckc
R0402~R0402_L1.0-W0.5-H0.4~1101 x 18
WIFIM-SMD_ESP32-C3-MINI-1~WIFIM-SMD_ESP32-C3-MINI-1~13lQ
SOT-89-5_L4.5-W2.5-P1.50-LS4.6-BL~SOT-89-5_L4.5-W2.5-P1.50-LS4.6-BL~4WXr
DFN0603-2L-BI~DFN0603-2L-BI-L0.6-W0.3-H0.3~PuRC x 2
C1206~C1206_L3.2-W1.6-H1.3~e1X0
USB-C-SMD_SOUHAN_TYPE-C-16PLT-H6.5~USB-C-SMD_SOUHAN_TYPE-C-16PLT-H6.5~AH2a
MIC-SMD_6P-L2.8-W1.9-P0.98-TL~MIC-SMD_6P-L2.8-W1.9-P0.98-TL~gMpa
IND-SMD_L4.4-W4.2~IND-SMD_L4.2-W4.4-H2.0~5kyt
SOT-23-5_L2.9-W1.6-P0.95-LS2.8-BL~SOT-23-5_L2.9-W1.6-P0.95-LS2.8-BL~qgnL
F1206~F1206_L3.2-W1.7-H0.6~XRz8
ESOP-8_L4.9-W3.9-P1.27-LS6.0-BL-EP~ESOP-8_L4.9-W3.9-H1.6-LS6.0-P1.27~GiWC
