elin66alpha/AI_figure/mechanic/export/背板.step

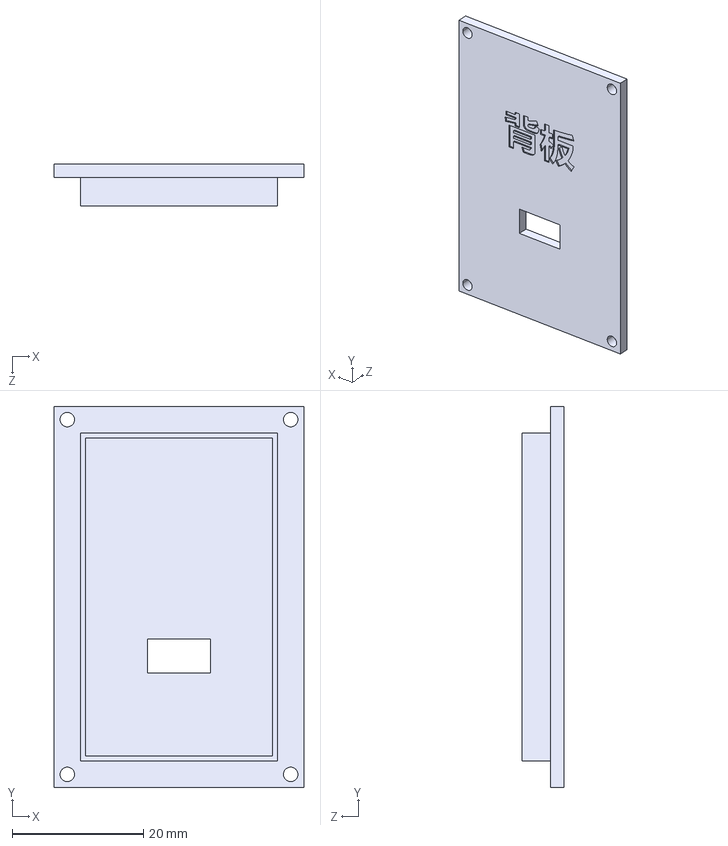
[picture p21: CAD file, 2026-10-10]
mechanic/export/背板.step
38.0 x 58.0 x 6.35 mm
