elin66alpha/AI_figure/mechanic/export/头部.step

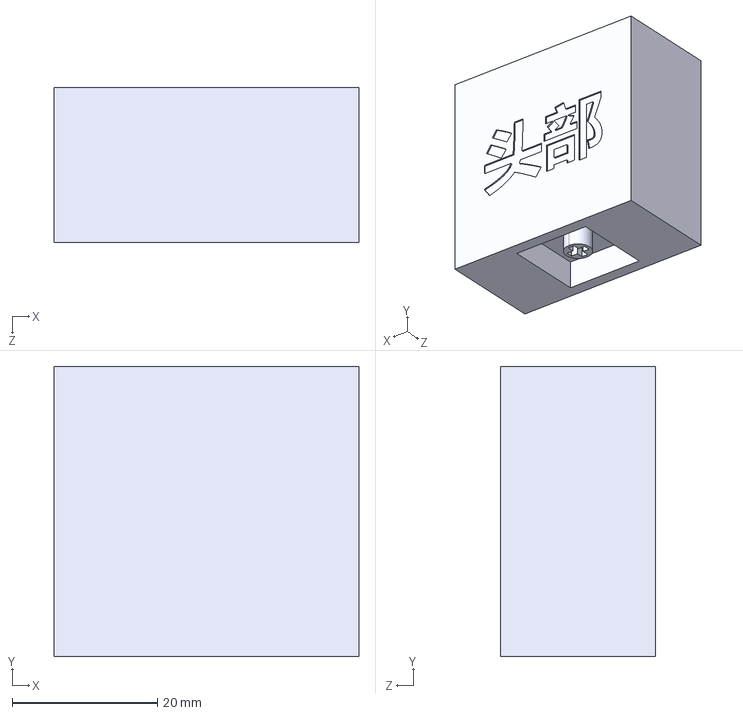
[picture p22: CAD file, 2026-10-10]
mechanic/export/头部.step
42.0 x 40.0 x 21.4 mm
