elin66alpha/AI_figure/mechanic/export/身体.step

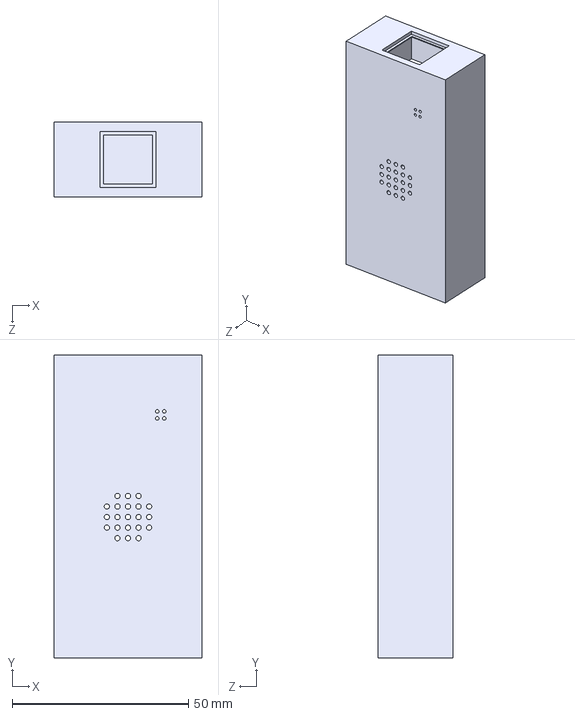
[picture p23: CAD file, 2026-10-10]
mechanic/export/身体.step
42.0 x 86.0 x 21.4 mm
