elin66alpha/AI_figure/mechanic/solidworks/AI_figure_装配.SLDASM

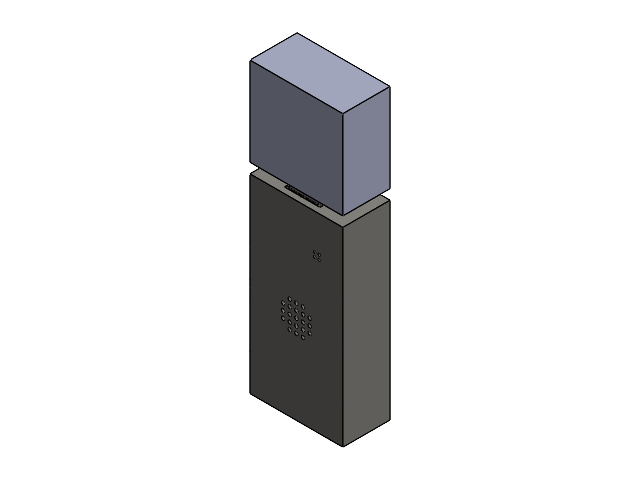
[picture p24: CAD file, 2026-10-10]
mechanic/solidworks/AI_figure_装配.SLDASM
PCB
电池
扬声器
身体
背板
MX __ ______________1.STEP
MX __ _________________.STEP
MX__ ____LEDLEDLED.STEP
MX__ ____ ____ ____2_________2_______.STEP
________________.STEP
头部
