elin66alpha/AI_figure/(list of files, cad)

Other CAD files:
mechanic/export/PCB.step
mechanic/solidworks/PCB/PCB.SLDPRT
mechanic/export/头部.STL
mechanic/export/背板.STL
mechanic/solidworks/parts/头部.SLDPRT
mechanic/solidworks/parts/身体.SLDPRT
