elin66alpha/AI_figure/hardware/assembly/VERIFY_REPORT.md

# 装配指南独立复核报告

- 指南：`AI_figure_装配指南.html`（生成于 2026-10-17T00:37:11）
- PCB 快照：2026-10-17T03:43:34Z  sha256 `72094341a8679973a66fca0e81470f40659014353dfc1a4fcc9d5d718a22242b`
- 结果：**全部通过**（50 个位号）

| 位号 | 面 | 值 | 面✓ | 坐标✓ | 焊盘/网络✓ | 是否贴片✓ | 采购/说明✓ | 值✓ | 极性✓ | 步骤✓ |
|---|---|---|---|---|---|---|---|---|---|---|
| C1 | bottom | 10µF 25V | ✓ | ✓ | ✓ | ✓ | ✓ | ✓ | ✓ | ✓ |
| C2 | top | 1µF 25V | ✓ | ✓ | ✓ | ✓ | ✓ | ✓ | ✓ | ✓ |
| C3 | top | 100nF 16V | ✓ | ✓ | ✓ | ✓ | ✓ | ✓ | ✓ | ✓ |
| C4 | bottom | 2.2µF 25V | ✓ | ✓ | ✓ | ✓ | ✓ | ✓ | ✓ | ✓ |
| C5 | bottom | 100µF 6.3V | ✓ | ✓ | ✓ | ✓ | ✓ | ✓ | ✓ | ✓ |
| C6 | bottom | 10µF 25V | ✓ | ✓ | ✓ | ✓ | ✓ | ✓ | ✓ | ✓ |
| C7 | bottom | 22µF 10V | ✓ | ✓ | ✓ | ✓ | ✓ | ✓ | ✓ | ✓ |
| C8 | bottom | 2.2µF 25V | ✓ | ✓ | ✓ | ✓ | ✓ | ✓ | ✓ | ✓ |
| C13 | bottom | 100nF 16V | ✓ | ✓ | ✓ | ✓ | ✓ | ✓ | ✓ | ✓ |
| C15 | top | 1µF 25V | ✓ | ✓ | ✓ | ✓ | ✓ | ✓ | ✓ | ✓ |
| C16 | bottom | 10µF 25V | ✓ | ✓ | ✓ | ✓ | ✓ | ✓ | ✓ | ✓ |
| C19 | bottom | 100nF 16V | ✓ | ✓ | ✓ | ✓ | ✓ | ✓ | ✓ | ✓ |
| C23 | bottom | 2.2µF 25V | ✓ | ✓ | ✓ | ✓ | ✓ | ✓ | ✓ | ✓ |
| D1 | bottom | SEUCS2X3V1B | ✓ | ✓ | ✓ | ✓ | ✓ | ✓ | ✓ | ✓ |
| D2 | bottom | SEUCS2X3V1B | ✓ | ✓ | ✓ | ✓ | ✓ | ✓ | ✓ | ✓ |
| D3 | top | 19-217/R6C-AL1M2VY/6T | ✓ | ✓ | ✓ | ✓ | ✓ | ✓ | ✓ | ✓ |
| D4 | bottom | SMF5.0A | ✓ | ✓ | ✓ | ✓ | ✓ | ✓ | ✓ | ✓ |
| F1 | bottom | BSMD1206-100-24V | ✓ | ✓ | ✓ | ✓ | ✓ | ✓ | ✓ | ✓ |
| J1 | bottom | TYPE-C 16PLT-H6.5 | ✓ | ✓ | ✓ | ✓ | ✓ | ✓ | ✓ | ✓ |
| J2 | top | PZ254V-11-02P | ✓ | ✓ | ✓ | ✓ | ✓ | — | ✓ | — |
| J3 | top | PZ254V-11-02P | ✓ | ✓ | ✓ | ✓ | ✓ | — | — | — |
| J4 | top | PZ254V-11-02P | ✓ | ✓ | ✓ | ✓ | ✓ | — | — | — |
| L1 | bottom | 2.2µH | ✓ | ✓ | ✓ | ✓ | ✓ | ✓ | ✓ | ✓ |
| R1 | bottom | 100kΩ | ✓ | ✓ | ✓ | ✓ | ✓ | ✓ | ✓ | ✓ |
| R2 | bottom | 100kΩ | ✓ | ✓ | ✓ | ✓ | ✓ | ✓ | ✓ | ✓ |
| R3 | bottom | 3kΩ | ✓ | ✓ | ✓ | ✓ | ✓ | ✓ | ✓ | ✓ |
| R4 | bottom | 5.1kΩ | ✓ | ✓ | ✓ | ✓ | ✓ | ✓ | ✓ | ✓ |
| R5 | bottom | 5.1kΩ | ✓ | ✓ | ✓ | ✓ | ✓ | ✓ | ✓ | ✓ |
| R6 | bottom | 33Ω | ✓ | ✓ | ✓ | ✓ | ✓ | ✓ | ✓ | ✓ |
| R7 | bottom | 33Ω | ✓ | ✓ | ✓ | ✓ | ✓ | ✓ | ✓ | ✓ |
| R8 | bottom | 0Ω | ✓ | ✓ | ✓ | ✓ | ✓ | ✓ | ✓ | ✓ |
| R9 | top | 10kΩ | ✓ | ✓ | ✓ | ✓ | ✓ | ✓ | ✓ | ✓ |
| R10 | bottom | 10kΩ | ✓ | ✓ | ✓ | ✓ | ✓ | ✓ | ✓ | ✓ |
| R11 | bottom | 10kΩ | ✓ | ✓ | ✓ | ✓ | ✓ | ✓ | ✓ | ✓ |
| R12 | bottom | 10kΩ | ✓ | ✓ | ✓ | ✓ | ✓ | ✓ | ✓ | ✓ |
| R13 | bottom | 330Ω | ✓ | ✓ | ✓ | ✓ | ✓ | ✓ | ✓ | ✓ |
| R14 | bottom | 1MΩ | ✓ | ✓ | ✓ | ✓ | ✓ | ✓ | ✓ | ✓ |
| R15 | bottom | 1MΩ | ✓ | ✓ | ✓ | ✓ | ✓ | ✓ | ✓ | ✓ |
| R16 | bottom | 68kΩ | ✓ | ✓ | ✓ | ✓ | ✓ | ✓ | ✓ | ✓ |
| R17 | bottom | 100kΩ | ✓ | ✓ | ✓ | ✓ | ✓ | ✓ | ✓ | ✓ |
| R18 | bottom | 100kΩ | ✓ | ✓ | ✓ | ✓ | ✓ | ✓ | ✓ | ✓ |
| TP1 | bottom | T-1.6x1.6x0.5 | ✓ | ✓ | ✓ | ✓ | ✓ | — | — | — |
| TP2 | bottom | T-1.6x1.6x0.5 | ✓ | ✓ | ✓ | ✓ | ✓ | — | — | — |
| TP3 | bottom | T-1.6x1.6x0.5 | ✓ | ✓ | ✓ | ✓ | ✓ | — | — | — |
| U1 | top | ESP32-C3-MINI-1-H4X | ✓ | ✓ | ✓ | ✓ | ✓ | ✓ | ✓ | ✓ |
| U2 | bottom | ETA6002E8A | ✓ | ✓ | ✓ | ✓ | ✓ | ✓ | ✓ | ✓ |
| U3 | bottom | ETA5060V330S8F | ✓ | ✓ | ✓ | ✓ | ✓ | ✓ | ✓ | ✓ |
| U4 | top | LMD2718T261-OA1 | ✓ | ✓ | ✓ | ✓ | ✓ | ✓ | ✓ | ✓ |
| U5 | bottom | NS4168 | ✓ | ✓ | ✓ | ✓ | ✓ | ✓ | ✓ | ✓ |
| U7 | bottom | TLV75733PDBVR | ✓ | ✓ | ✓ | ✓ | ✓ | ✓ | ✓ | ✓ |
