elin66alpha/AI_figure/(list of files, drawings)

Other design files:
.easyeda/artifacts/20261007-025257-pcb_dsn-23360ca7.dsn
