elin66alpha/AI_figure/firmware/ESP32C3_AI_Voice/net_wifi.h

#pragma once
#include <stdint.h>
#include <stddef.h>
#include "esp_netif_ip_addr.h"

// WiFi 连接 + 指数退避重连(AGENT.md §3.1:1s -> 2s -> 4s -> ... -> 30s 封顶)。
//
// 全程非阻塞:netWifiBegin() 只发起连接,后面靠 loop 里的 netWifiUpdate() 推进。
// 不用 SDK 自带的自动重连(已显式关掉),否则两套重连逻辑会互相打架,
// 表现是退避时间对不上、日志里看到莫名其妙的状态跳变。

// 凭据存 NVS 命名空间 "net"(BLE 配网写入),为空时回落到 secrets.h 的 WIFI_SSID/WIFI_PASS。
bool      netWifiHasCreds();     // NVS 或 secrets.h 里有没有 SSID
bool      netWifiSaveCreds(const char *ssid, const char *pass);   // 只由配网调用

void      netWifiBegin();
void      netWifiInit();
void      netWifiStop();
void      netWifiUpdate();       // 每次 loop 都调一次
bool      netWifiIsUp();
void      netWifiForceRetry();   // 跳过退避立刻重试(ERROR 态按键触发,AGENT.md §5)
int32_t   netWifiRssi();
esp_ip4_addr_t netWifiIp();
uint32_t  netWifiDisconnectCount();   // 进遥测,盯 AGENT.md §6 第 4 条说的"重连 N 次之后"
