elin66alpha/AI_figure/(commit log)

2026-09-22 Initial commit
    ESP32-C3 AI voice assistant firmware and renderer assets.
2026-09-23 Stage 6~7 + rev.5:设备网络层、回声服务器、公网 VPS + wss:// TLS-PSK
    设备侧(Stage 6/7,此后设备侧只加逻辑不改结构):
    - 上电自连 WiFi、断线自愈、LED + 本地提示音、常驻堆遥测
    - 持久 WS 客户端 + 环形缓冲 + TCP 背压 + I2S 播放:按住说话 -> 松开 ->
    听到自己的声音从服务器回来
    - Stage 1~5 硬件验收台整体删除(代码留在 f955db1)
    服务器侧(Stage 6.5):协议级回声服务器,说全套 AGENT.md §5.2 协议,
    pacer 首包突发 300 ms 后 1x 实时整形;tools/smoke_echo.py 自测。
    rev.5:服务器迁到公网 VPS(systemd),Python 只听 127.0.0.1,
    stunnel 终结 TLS 1.2 纯 PSK;wss:// 从 Stage 12 提前落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
2026-09-23 Stage 8~9:服务器 TTS / ASR 单通 + LLM 模块,默认全走阿里云百炼
    三样各两家,一个环境变量切换,session.py / pacer / 固件都不关心是哪家:
    ASR_PROVIDER = ali(qwen-audio-3.1-asr-flash-streaming)/ volc
    TTS_PROVIDER = ali(qwen3-tts-flash-realtime)/ volc
    LLM_PROVIDER = qwen(qwen3.5-flash-2026-02-23)/ deepseek(deepseek-flash)
    DASHSCOPE_REGION=cn/intl 统一决定百炼地址(key 与地域绑定)。
    Stage 8(TTS):ali_tts / volc_tts / volc_proto / tts 分派;pacer 改吃异步
    迭代器;拿到首块音频才发 audio_begin;调试消息 {"t":"say"};
    tools/pc_client.py(say / turn / --mode / --abort-after)。
    Stage 9(ASR):asr 外壳 + ali_asr / volc_asr,turn_start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
2026-09-23 Stage 10:全链路对话 —— ASR -> LLM 切句 -> TTS,三段解耦不断顿
    REPLY_MODE=chat(pc_client --mode chat):
    - pipeline.py:LLM task -> 句队列 -> TTS task -> PCM 队列 -> pacer。
    拆成后台 task 是不断顿的关键:TTS 挂在 pacer 下面只能 1x 实时前进,
    句间 commit->首包 ~0.35 s 会啃穿 300 ms 余量
    - ali_tts.AliTtsSession:一条连接顺序 commit 多句(真连实测顺序不乱);
    turn_end 一到就建连,和 ASR 收尾 / LLM 首句并行
    - volc_tts.VolcTtsSession / tts.open_session():同一接口,火山每句一条连接
    - session:chat 模式;每句下发 {"t":"reply"}(设备静默忽略);
    对话历史按设备 ID 存,断线重连后还在;打一行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
2026-09-23 Stage 11: 等待音效(fw 0.3)+ 服务器 TTS 预热,真机验收通过
    固件(fw 0.3):
    - bubble.*:非阻塞的冒泡声发生器。每个气泡是音调上扬、指数衰减的正弦,
    成串冒、串间停顿,参数伪随机抖动。零浮点:查 cue 的正弦表,相位 Q32、
    包络 Q15、xorshift32
    - session:收到 cue thinking(仅 WAITING)开始冒泡,audioWrite 当节拍器,
    loop 照常 wsPoll;audio_begin 后预缓冲攒够前接着冒泡,攒够后等气泡间隙
    再切,功放不关,无缝接回复;WAITING 时收到 error 立刻回 IDLE,不干等 8 s;
    不认识的 cue 名打日志忽略;遥测在放等待音效时也推迟
    - 固件 +1342 B flash / +688 B 静态 RAM(1089543 B =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
    [ESP32C3_AI_Voice.ino, bubble.cpp, bubble.h, config.h, cue.cpp, cue.h]
2026-09-24 打磨第 1/2 批:LLM 连接预热 + 服务器/固件冗余清理;记录 App 路线图 (#1)
    服务器
    - S1:chat 模式 turn_start 时后台 HEAD /models 预热 LLM 连接(不耗 token),
    空闲连接保留 15 s -> 60 s。真机一问一答间隔通常 >15 s,之前每回合都冷启动。
    实测(本机,无密钥)新建连接 1734 ms / 复用 250 ms。开关:LLM_PREWARM / LLM_KEEPALIVE_S
    - 删未调用的 pacer.pace_pcm / on_progress
    - 两份"后台关 WS"合并到 aioutil.py
    - asr/chat 模式不再攒整段录音(只有 echo 要),改记字节数
    - 删 _asr_turn 里的死分支
    固件(fw 0.3.1,行为与 0.3 相同)
    - 删标定期遗留、零调用的接口;MIC_SHIFT / DC blocker 改编译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
2026-09-24 固件 F1~F4(fw 0.3.2):停播少等 66 ms、打断立刻关功放、wsPoll 少做 TLS 查询、上行零拷贝 (#2)
    - F1 audioStopPlayback:删掉补静音后的 delay(70)。i2s_channel_write 只能拿到 DMA
    已播完的描述符来写,静音写满 4 个描述符时真实音频已经播完,那 70 ms 等的是静音。
    只留 AMP_TAIL_MS=4 给 I2S TX FIFO
    - F2 打断走新的 audioCutPlayback:立刻关功放,不播被打断回复的尾巴,开麦快 ~130 ms。
    DMA 残留的旧音频由下一次 audioStartPlayback 多推一整个 DMA 的静音冲掉(s_txDirty)
    - F3 wsIsConnected() 不再碰 socket(NetworkClientSecure::connected() 内部是一次
    mbedtls_ssl_read + lwIP recv);wsPoll 每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
2026-09-27 BLE 配网(fw 0.4.0)+ 微信小程序 miniprogram/
    固件:
    - 新增 net_prov:独立的配网开机模式(没凭据 / 上电按住按键 3 s),
    WiFiProv Security 1、无 PoP,连通后凭据存 NVS 再重启;LED 双闪 + cueProv 提示
    - net_wifi 凭据改读 NVS,secrets.h 的 WiFi 只作开发板兜底
    - flash +371 KB,分区须改 Minimal SPIFFS (1.9MB APP with OTA)
    小程序(纯 JS,无 npm):
    - 扫描 AIFIG_ 设备 -> Sec1 握手 -> 下发 WiFi -> 轮询状态;失败在同一会话 ctrl reset 后重试
    - 自带 X25519 / AES-256-CTR;22 个 Node 测试(含按 C 源码独立实现的模拟设备)全过
    文档:AGENT.md §5.7 / §9.5,ROADMAP 改为小程序路线,miniprogram/README.md
    尚未真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
    [ESP32C3_AI_Voice.ino, config.h, cue.cpp, cue.h, led.cpp]
2026-10-07 硬件：30×50 PCB 布局定稿 + 布线交接文档
    - 原理图：J1 换立贴 TYPE-C 16PLT-H6.5（C3151748）；L1 换 FXL0420（C167206）；
    C5 换 100µF 1206 MLCC（C15008）；删除电池保护（U6/Q1/R16/R17/C22，J2- 直接接地）；
    SW2/SW3 改 TP1 EN / TP2 GND / TP3 BOOT 测试焊盘；R3 改 3.0k（500mAh，约 0.33A）。
    - PCB：30×50 两层板，布局已确认、尚未布线。U1 天线朝上贴左上角，麦克风右上 + Ø10 密封圈，
    500mAh 电池贴正面，USB-C 立式在背面中部；天线、麦克风、电池三个禁布区已建好。
    - 文档：新增 PCB_ROUTING_HANDOFF_2026-10-07.md（给布线 Agent），更新 DESIGN_CONSTRAINTS /
    TAKEOVER_CH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
    [BOM_30x50_2026-10-07.csv, sch-final.json]
2026-10-08 硬件：定稿清理，只保留最终工程、BOM、手册与设计约束
    - 删除 eda-design/eda-tools/sch-check 等过程文件、旧备份、旧 BOM 与过时文档
    - 新增最终工程导出 ProPrj_AI_figure_2026-10-08.epro2
    - 新增 datasheets/：最终 BOM 在用器件手册（含 U4 LMD2718T261-OA1）
    - 新增 DESIGN_CONSTRAINTS.md：最终板子、机械、电路取舍与下单前状态
    [diff_edit.txt, sch-final.json, schematic-u3-recovery-live.json]
2026-10-08 硬件定稿：清理 hardware/，保留最终工程、BOM、手册与设计约束 (#3)
    * BLE 配网(fw 0.4.0)+ 微信小程序 miniprogram/
    - 自带 X25519 / AES-256-CTR;22 个 Node 测试(含按 C 源码独立实现的模拟设备)全过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
    [BOM_30x50_2026-10-07.csv]
2026-10-08 固件迁移 ESP-IDF 6.1.0，同步电池检测与硬件工程
    将 Arduino 入口、网络、配网和外设接口迁移为原生 ESP-IDF 6.1.0。
    接入 PDM 麦克风、NS4168、VBAT 采样与 GPIO20 USB 检测；
    加入试板低电压阈值、仅按键唤醒和 20 分钟待机深睡。
    同步当前 EDA 工程、BOM、原理图 PDF、设计约束及已有 EDA 导出和工具资料。
    更新构建说明、英文临时路径构建脚本及本机电源/PDM 测试。
    验证：本机 ESP-IDF 6.1.0 完整构建与分区检查通过，电源策略及 PDM 测试通过。
    录音、ADC 精度和整板深睡电流仍需实板验收。
2026-10-10 机械：玩偶装配示意模型（SolidWorks）+ 目录整理
    mechanic/ 只含 PCB/MX STEP、SolidWorks 零件与总装配（含爆炸视图）、背板/身体/头部的 STEP AP214 与 STL；esp32_server/ 改名为 server/，renderer/ 移到 assets/renderer/（内容不变）；.gitignore 排除 mechanic 的脚本/截图/文档和 SolidWorks 锁文件。
2026-10-17 硬件：手工装配指南（交互式 HTML + 3D）+ 忽略本地 EDA 工具包
    - hardware/assembly：AI_figure 主板手工贴片指南（单文件 HTML，断网可用）
    - 2D 板图点选元件，显示完整型号/参数、正反面、离板边距离、方向
    - 左侧焊好后的 3D 视图（来自 EasyEDA 导出的 PCB.step）
    - 建议顺序：正面先焊、U1 第一个，背面最后焊 J1，最后焊线
    - 采购清单转录 purchase.csv，4 处换料已按立创参数核对等效
    - VERIFY_REPORT.md：50 个位号逐项独立复核全部通过
    - .gitignore：hardware/eda-agent-pack/ 只留本地，不上传
    - .claude/launch.json：本地预览指南用的静态服务器
    Co-Auth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
2026-10-17 机械/硬件：STEP 导出归档到 mechanic/export，补充 3D 模型与 BOM 下单截图
    - mechanic/MX .STEP、mechanic/PCB.step 移到 mechanic/export/（内容不变）
    - 新增 mechanic/3D_PCB1_2026-10-17.step、mechanic/export 下的参考图
    - hardware/BOM：立创下单截图（purchase.csv 的转录来源）
    - .easyeda/artifacts：装配指南背面镜像核对用的两张 EasyEDA 截图
    - hardware/assembly/README.md：下单截图改回仓库内链接
2026-10-24 固件/硬件：离线硬件自检固件 + 远程自检包
    - firmware/ESP32C3_HwTest：不联网的自检固件（LED、喇叭、按键、PDM 麦克风录放、
    电池电压、USB 检测），直接复用生产驱动，通过 USB-Serial-JTAG 单字母命令驱动；
    build.ps1 用 ASCII 临时目录构建，并把合并镜像复制进自检包
    - hardware/bringup/自检包：给远程工程师用的 1-自检.bat / 2-诊断.bat
    （PowerShell 5.1）；自动复位刷不进去时，引导用镊子短接 BOOT/GND 后用 no-reset 重刷
    - 开发者说明：测试判定、串口协议、准备流程、结果处理
    - 文档中去掉所有万用表测量步骤（AGENT.md、生产固件 README）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
2026-10-24 文档：删除过时信息，按当前定制板和 ESP-IDF 固件重写规格
    - 删除旧的 SuperMini + 模块接线文档（ESP32_C3_AI_Voice_MVP_Battery_Wiring_v3.md）
    - AGENT.md 重写为当前设备侧规格：协议、音频播放、状态机、资源约束、TLS-PSK、BLE 配网；
    去掉 Arduino / SuperMini / INMP441 / MAX98357A、阶段验收记录和修订历史
    - SERVER.md 重写：去掉阶段实测记录、修订历史和过期的部署评估，章节重新编号
    - ROADMAP、DESIGN_CONSTRAINTS、固件 / 小程序 / 部署 README 更新到当前硬件和固件
    - 固件和服务器代码注释：AGENT.md / SERVER.md 章节号同步，去掉 Stage / rev 标签；
    服务器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
